donnerruebe/HEC-LadyBug/cad/hec-base/PCB-Outline.dxf

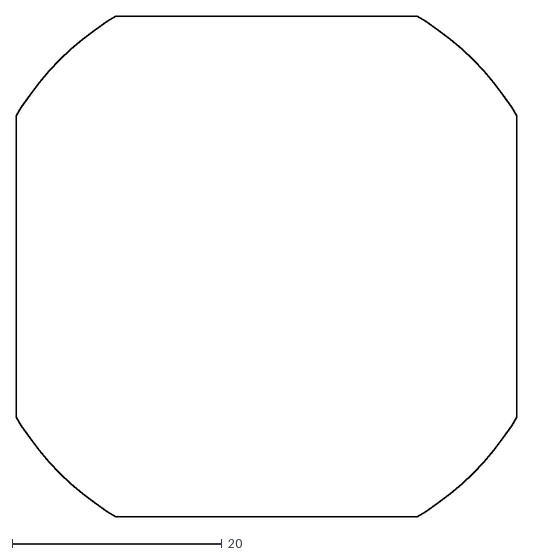
[picture p1: CAD file, 2022-08-14]
cad/hec-base/PCB-Outline.dxf
47.8 x 47.8
