donnerruebe/HEC-LadyBug/SLP/HEC-Base-Board_SCH_color.pdf

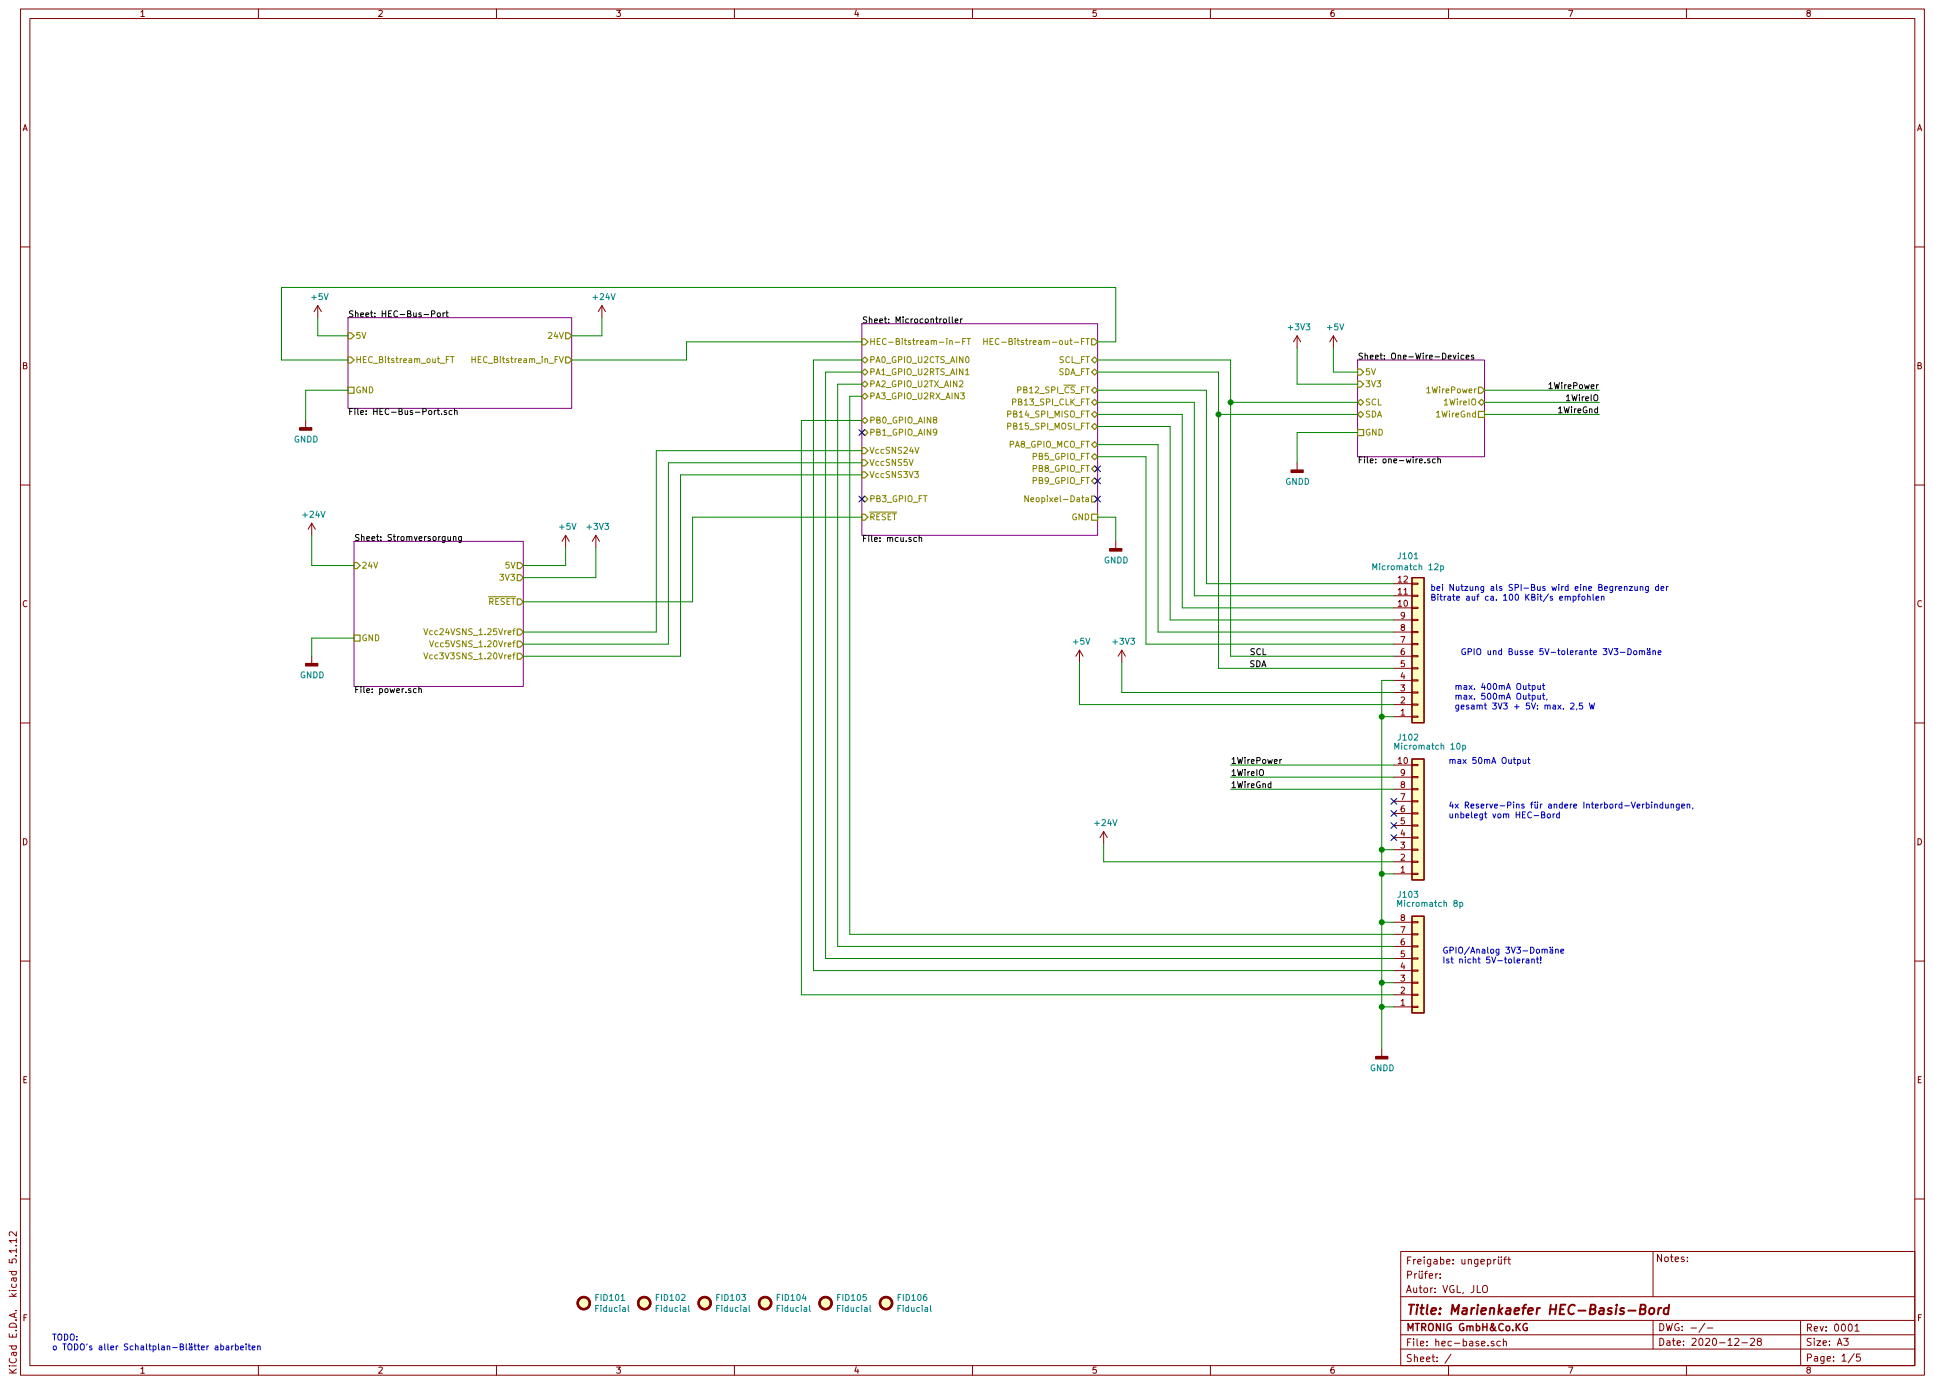
[picture p7: page 1]

Sheet: One-Wire-Devices File: one-wire.sch

GNDD GNDD

11
10

bei Nutzung als SPI-Bus wird eine Begrenzung der
Bitrate auf ca. 100 KBit/s empfohlen

Ist nicht 5V-tolerant! GPIO und Busse 5V-tolerante 3V3-Domäne

4x Reserve-Pins für andere Interbord-Verbindungen,
unbelegt vom HEC-Bord

File: hec-base.sch Sheet: / Autor: VGL, JLO
Title: Marienkaefer HEC-Basis-Bord

TODO: o TODO's aller Schaltplan-Blätter abarbeiten

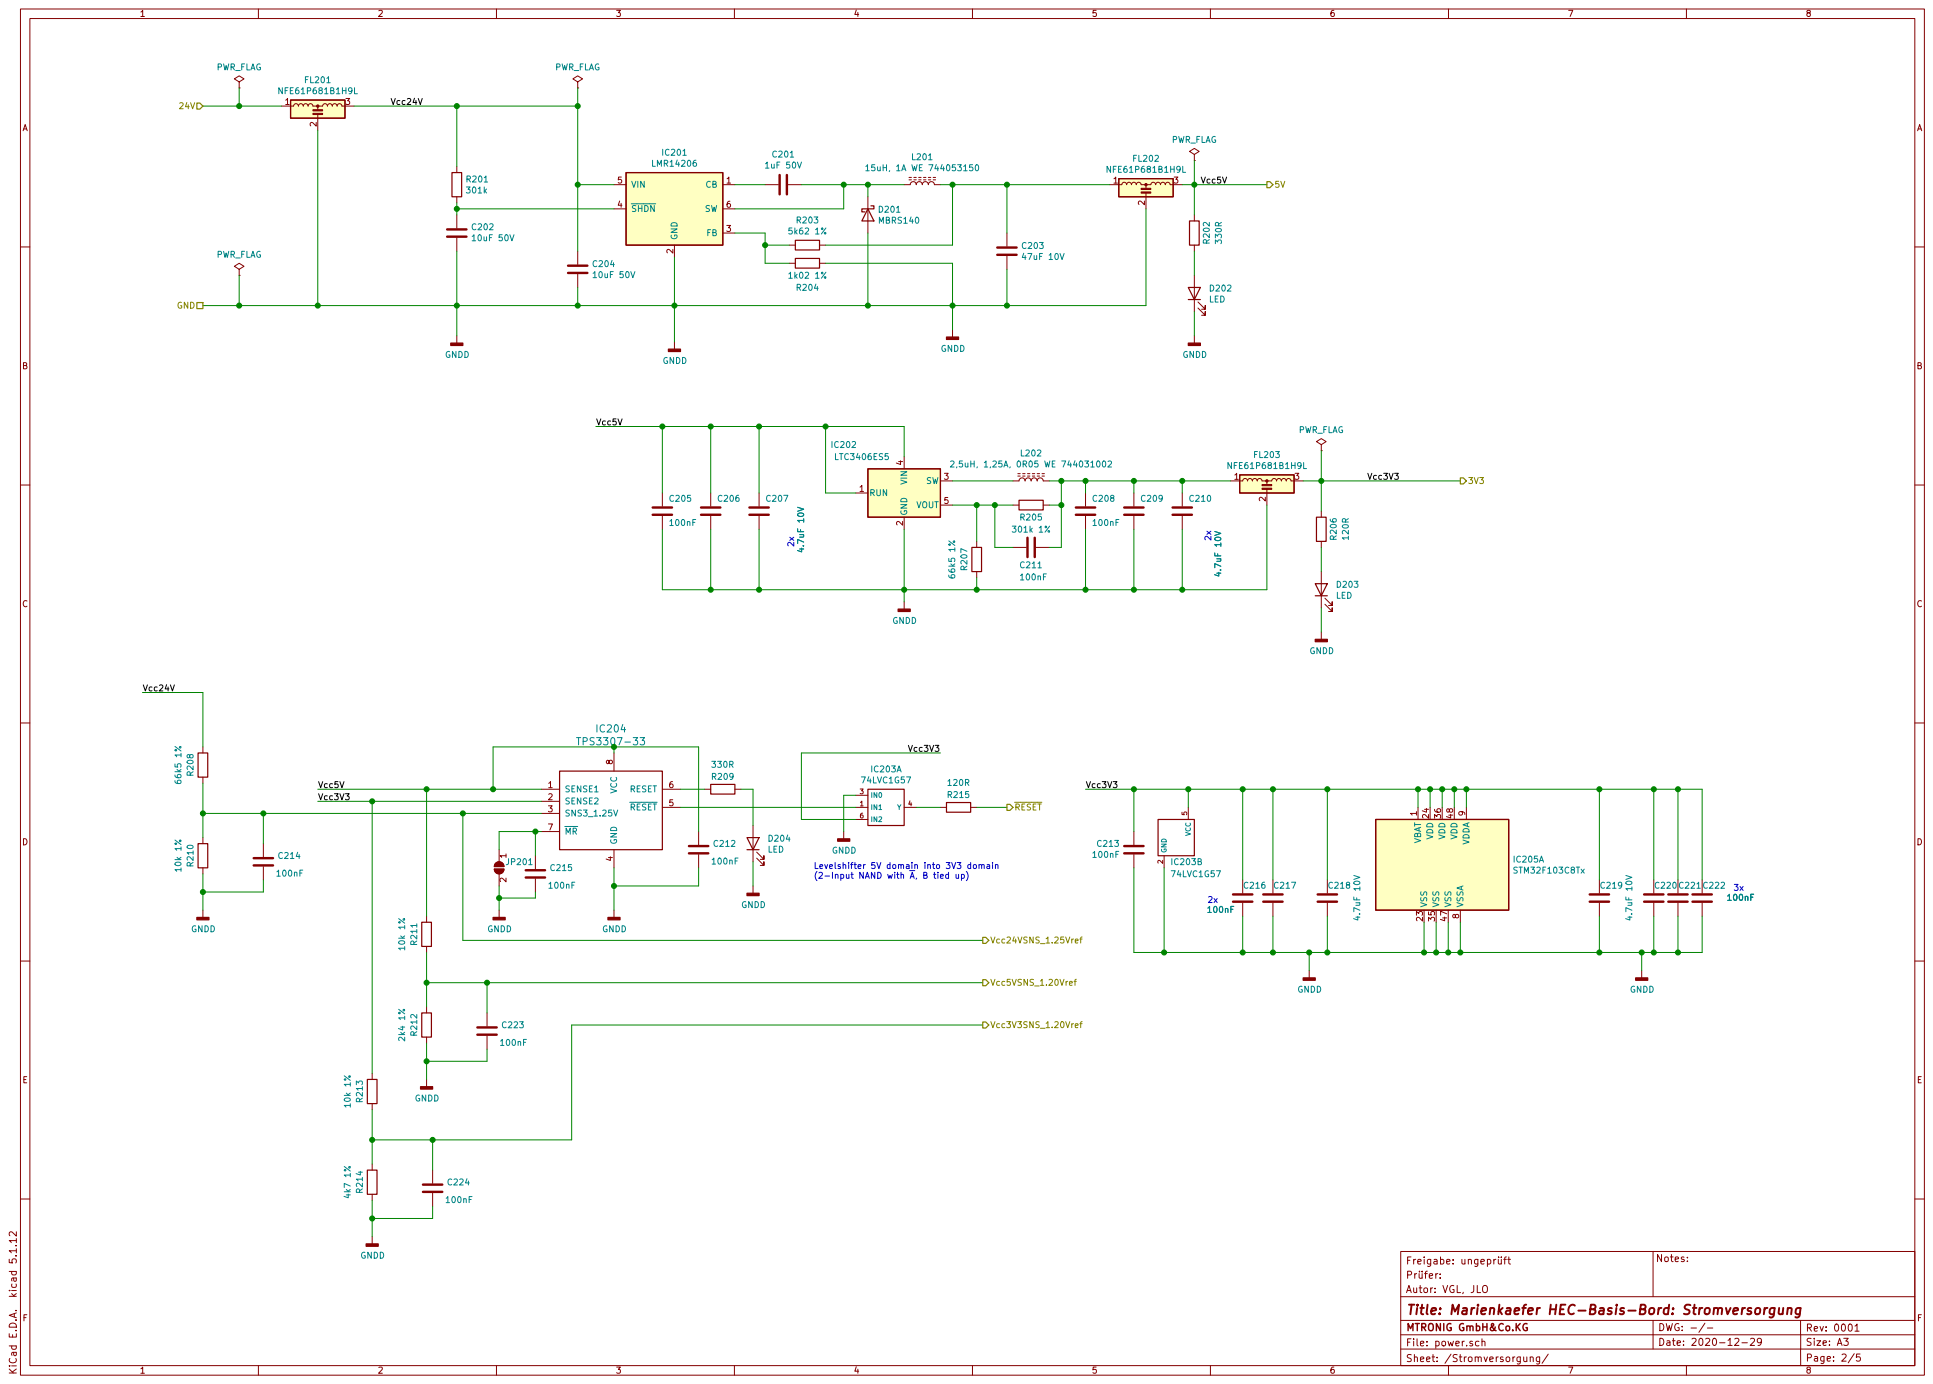
[picture p8: page 2]

2 FB 3 SHDN 4 VIN 5 SW 6

1 VSS 23 VDD 24 VSS 35 VDD 36 VSS 47 VDD 48 VSSA

GNDD
3x Levelshifter 5V domain into 3V3 domain

Autor: VGL, JLO
Title: Marienkaefer HEC-Basis-Bord: Stromversorgung

Rev: 0001 Size: A3 Page: 2/5 | F Date: 2020-12-29

File: power.sch
Sheet: /Stromversorgung/

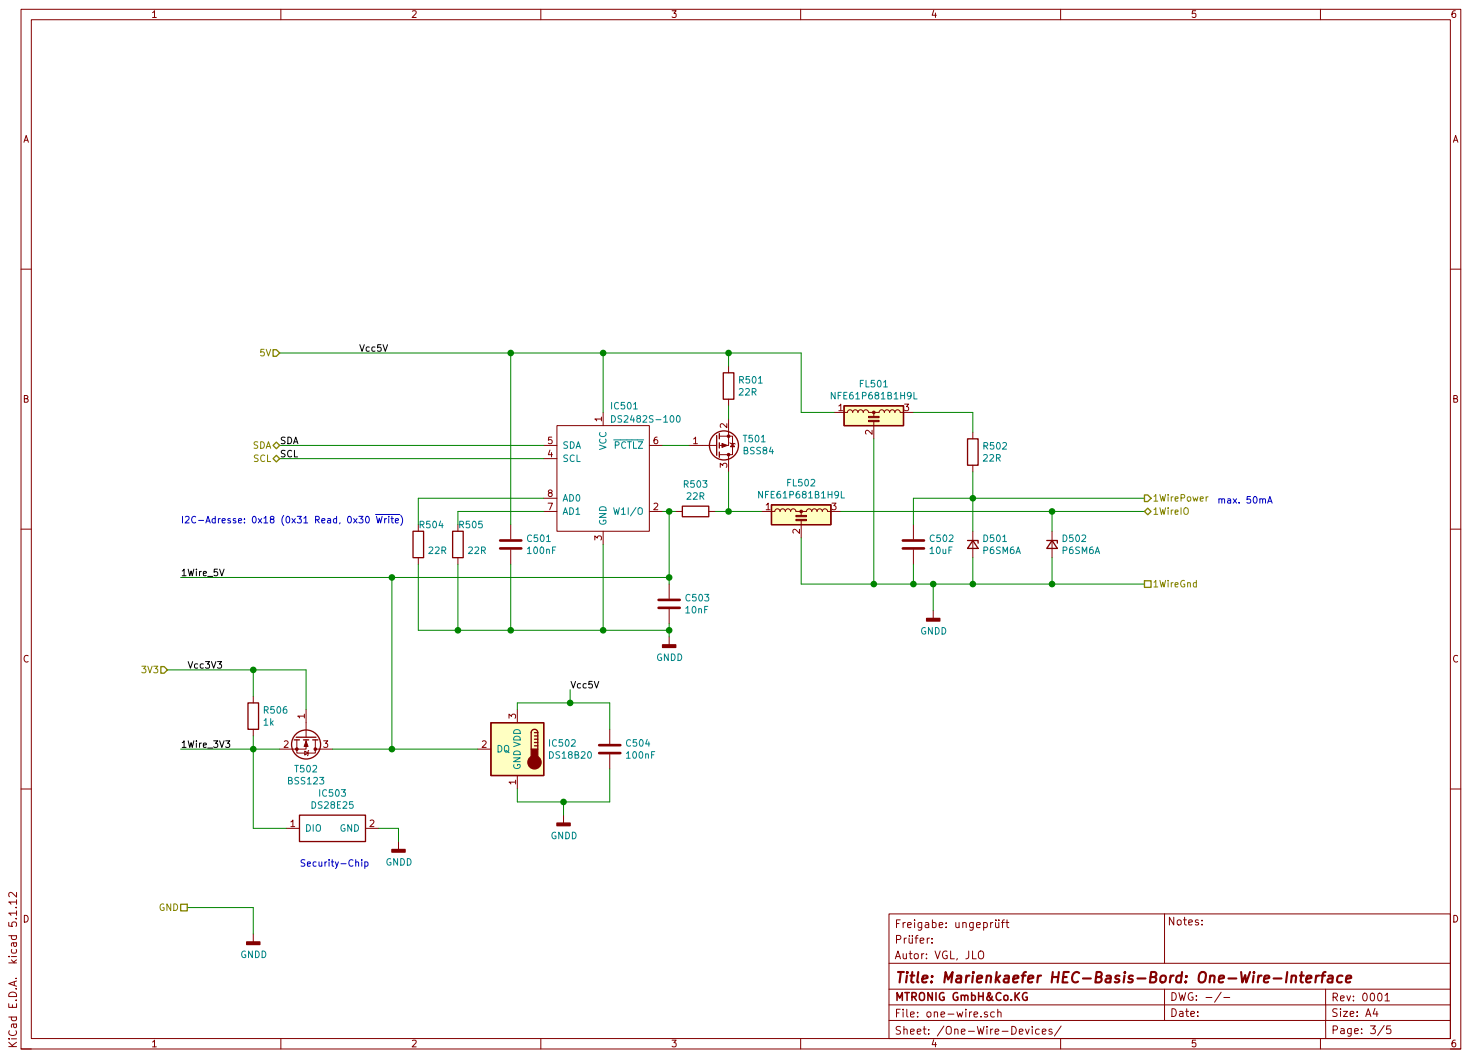
[picture p9: page 3]

File: one-wire.sch Sheet: /One-Wire-Devices/ Autor: VGL, JLO
Title: Marienkaefer HEC-Basis-Bord: One-Wire-Interface

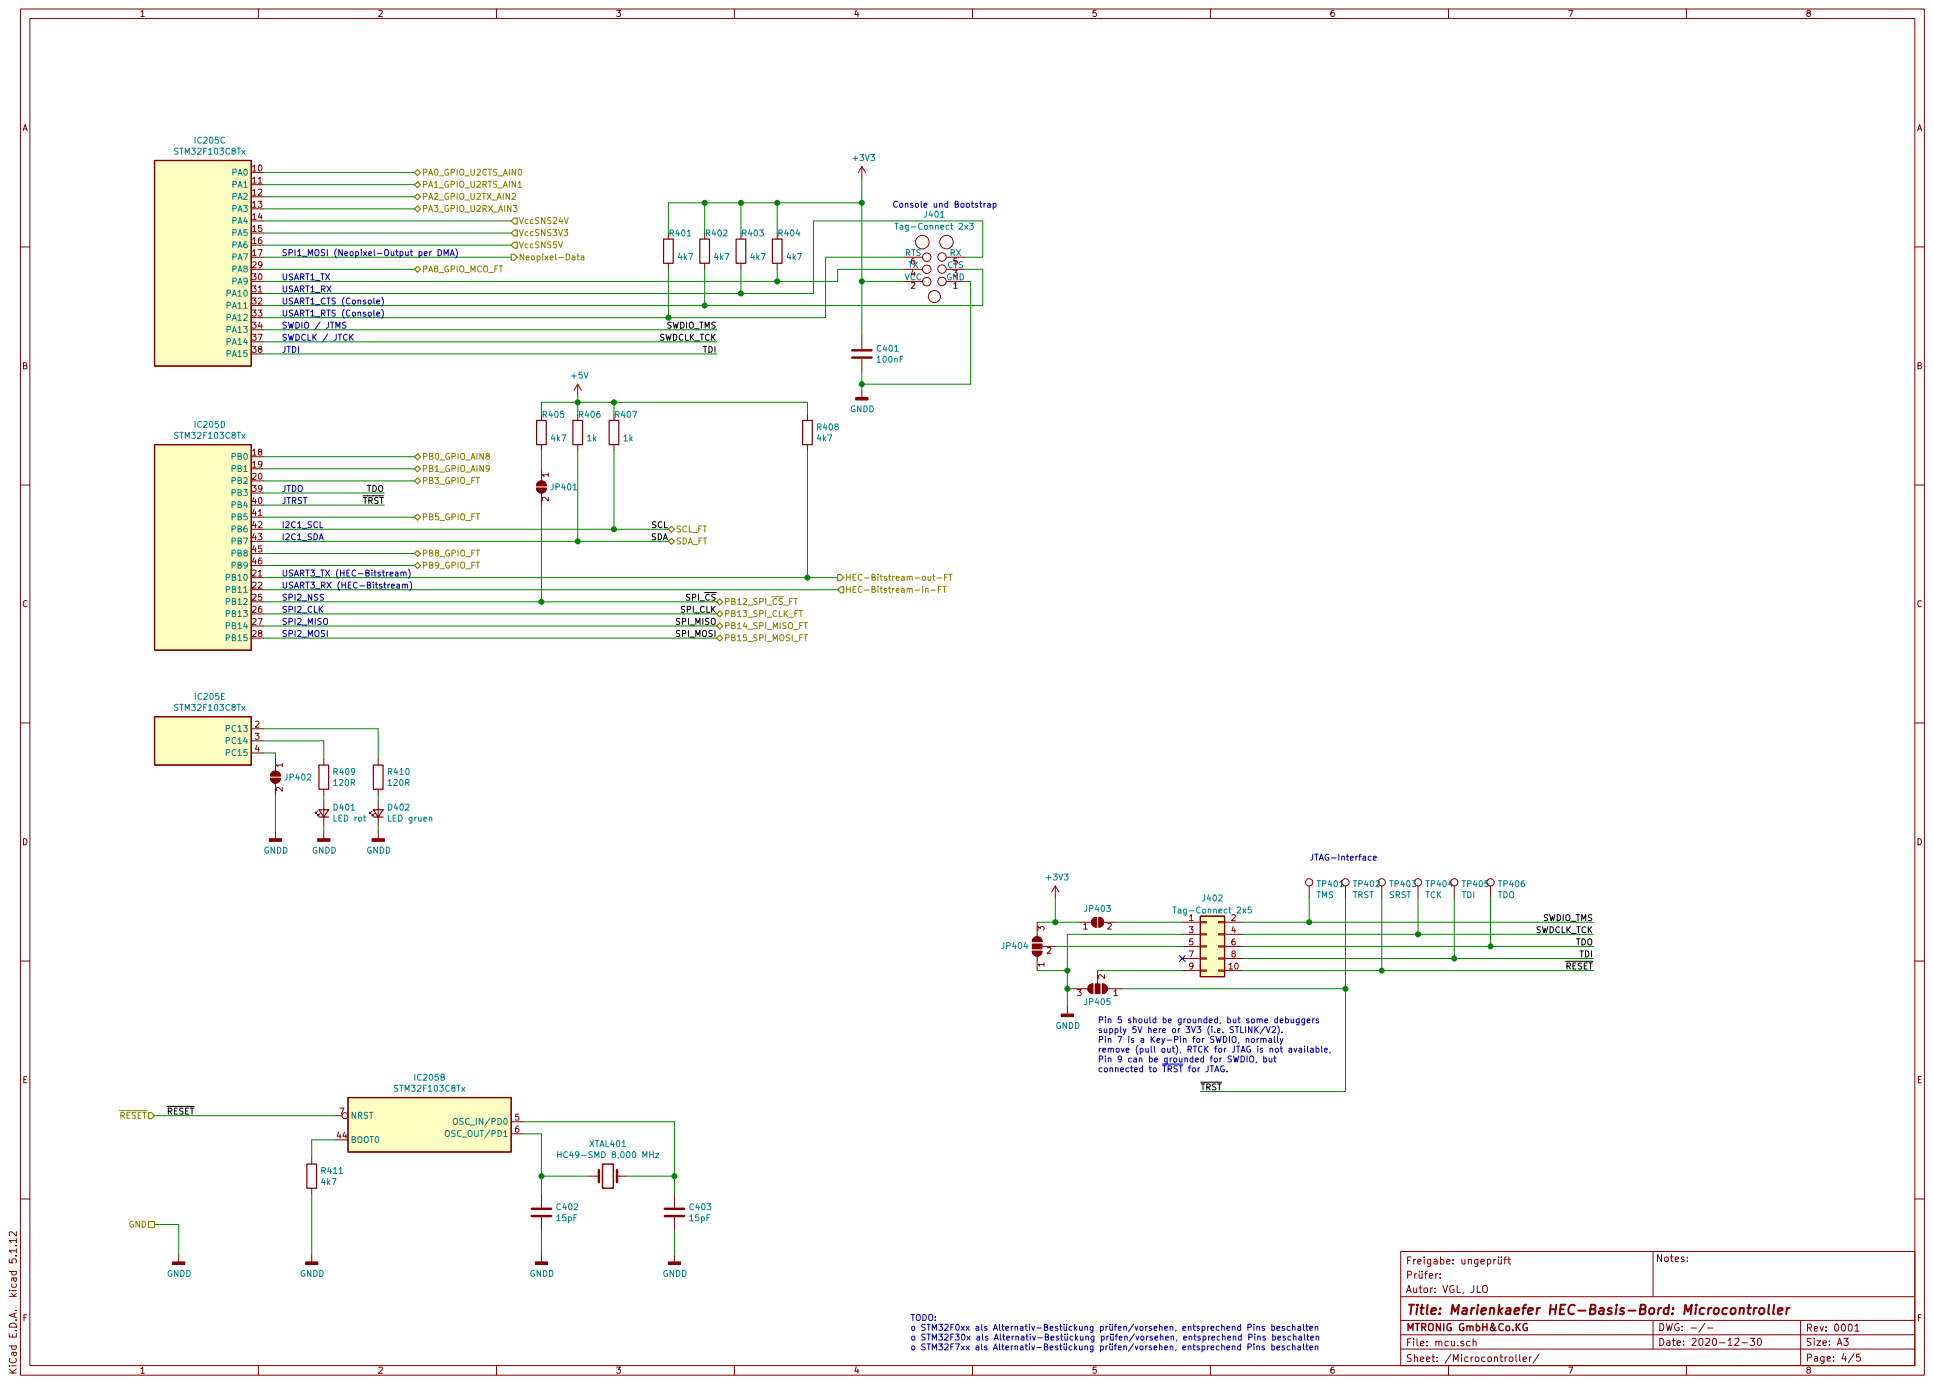
[picture p10: page 4]

SPI1_MOSI (Neopixel-Output per DMA) JTDO
JTRST USART1_TX
USART1_RX USART1_CTS (Console)
JTDI SPI2_NSS

Pin 5 should be grounded, but some debuggers
supply 5V here or 3V3 (i.e. STLINK/V2).
Pin 7 is a Key-Pin for SWDIO, normally
remove (pull out), RTCK for JTAG is not available,
Pin 9 can be grounded for SWDIO, but connected to TRST for JTAG.

Title: Marienkaefer HEC-Basis-Bord: Microcontroller File: mcu.sch Sheet: /Microcontroller/ Autor: VGL, JLO

TODO: o STM32F0xx als Alternativ-Bestückung prüfen/vorsehen, entsprechend Pins beschalten

o STM32F30x als Alternativ-Bestückung prüfen/vorsehen, entsprechend Pins beschalten
o STM32F7xx als Alternativ-Bestückung prüfen/vorsehen, entsprechend Pins beschalten

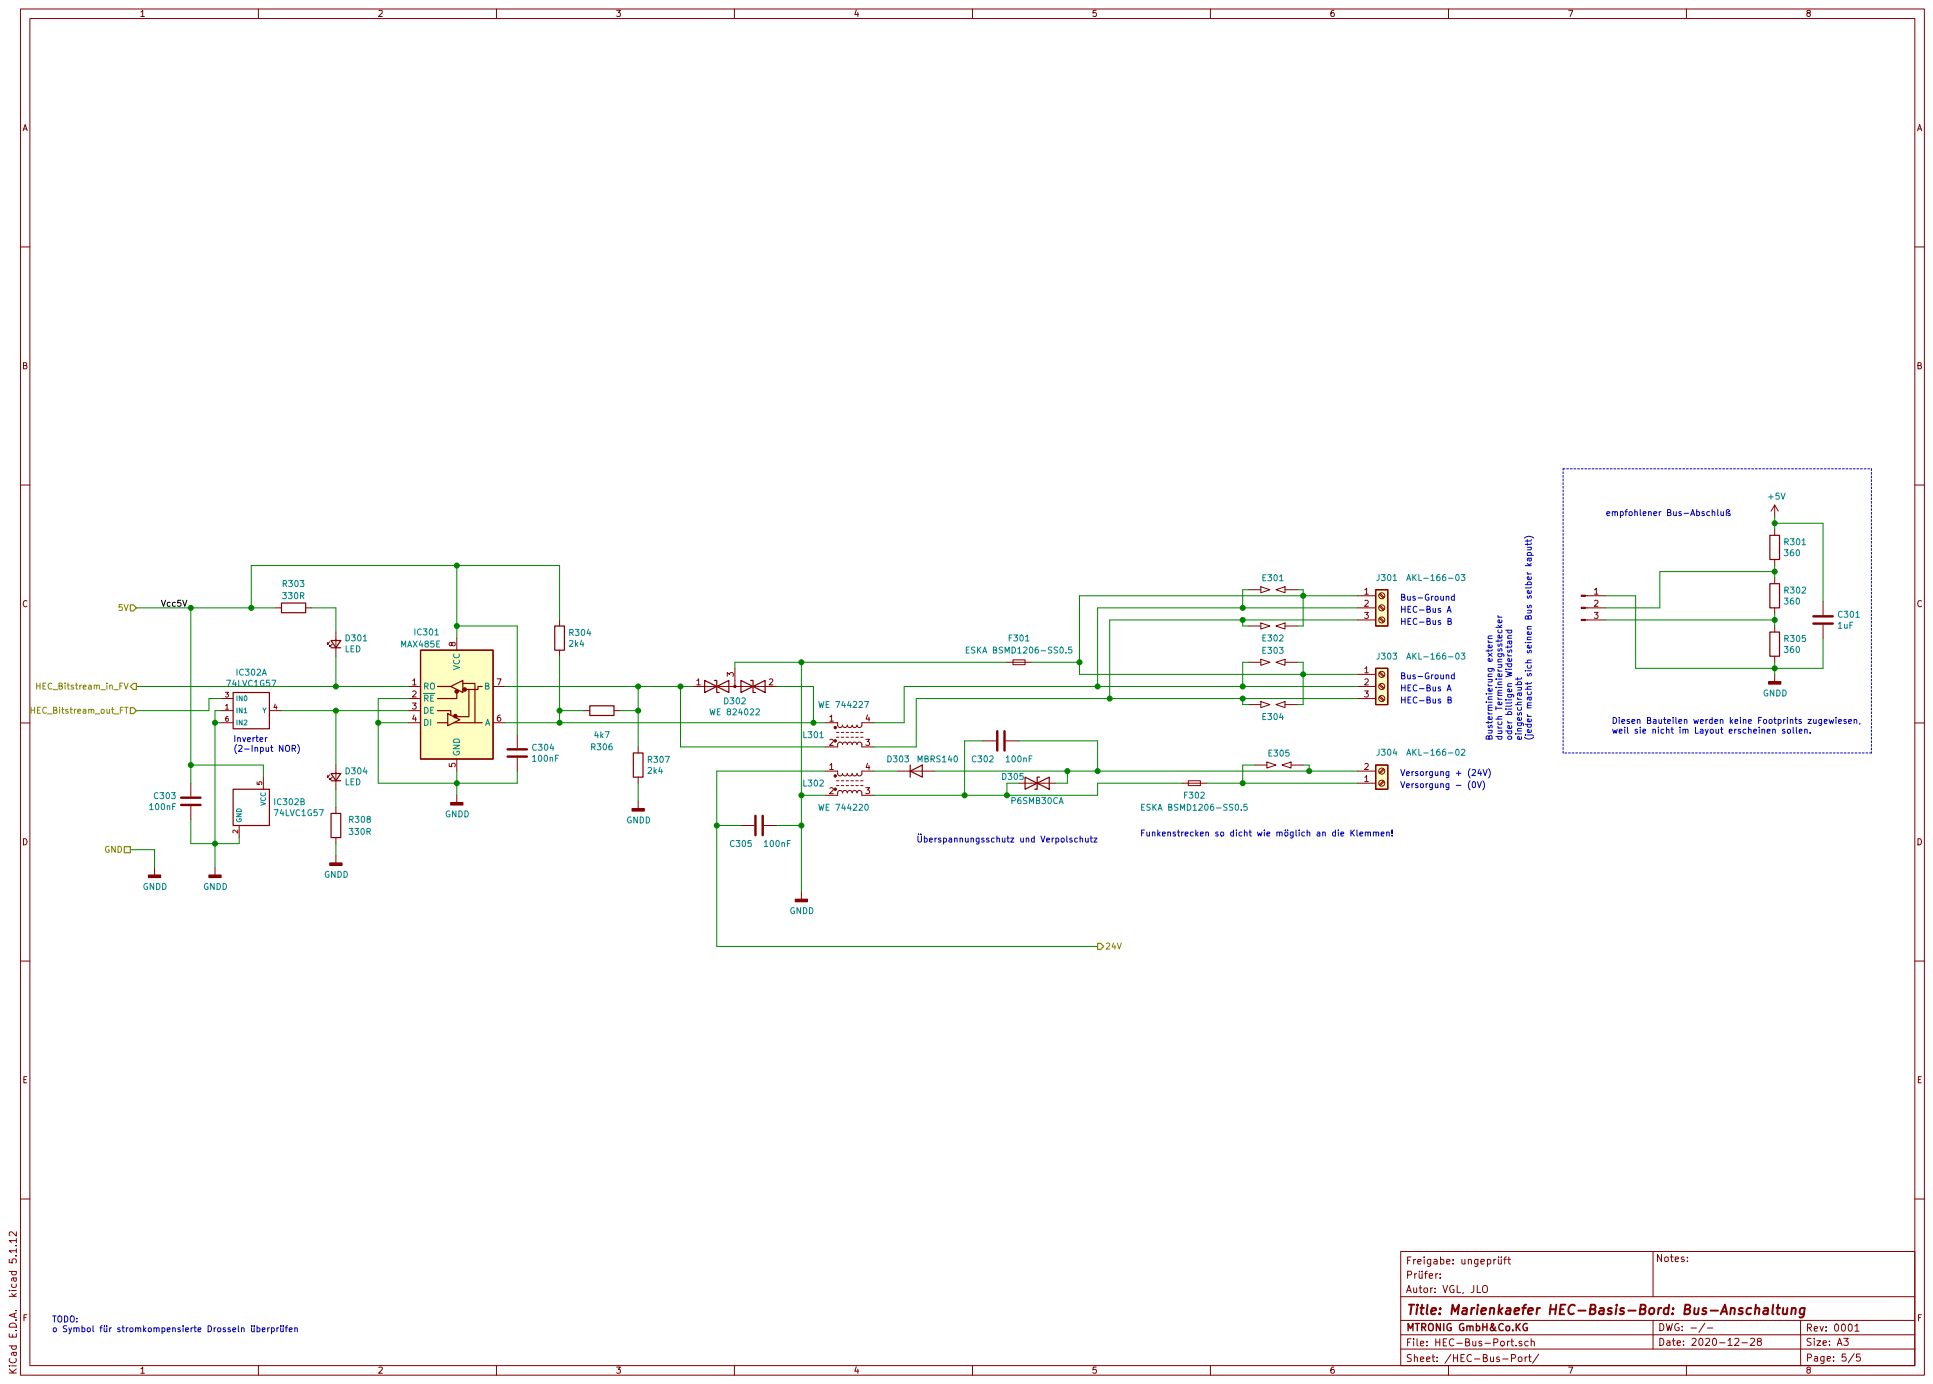
[picture p11: page 5]

Bus-Ground HEC-Bus A
Bus-Ground HEC-Bus A HEC-Bus B

Diesen Bauteilen werden keine Footprints zugewiesen,
weil sie nicht im Layout erscheinen sollen.

File: HEC-Bus-Port.sch Sheet: /HEC-Bus-Port/ Autor: VGL, JLO
Title: Marienkaefer HEC-Basis-Bord: Bus-Anschaltung

TODO: o Symbol für stromkompensierte Drosseln überprüfen
