donnerruebe/HEC-LadyBug/cad/hec-base/hec-base.kicad_pcb

## KiCad design cad/hec-base/hec-base.kicad_pcb (2022-08-14)

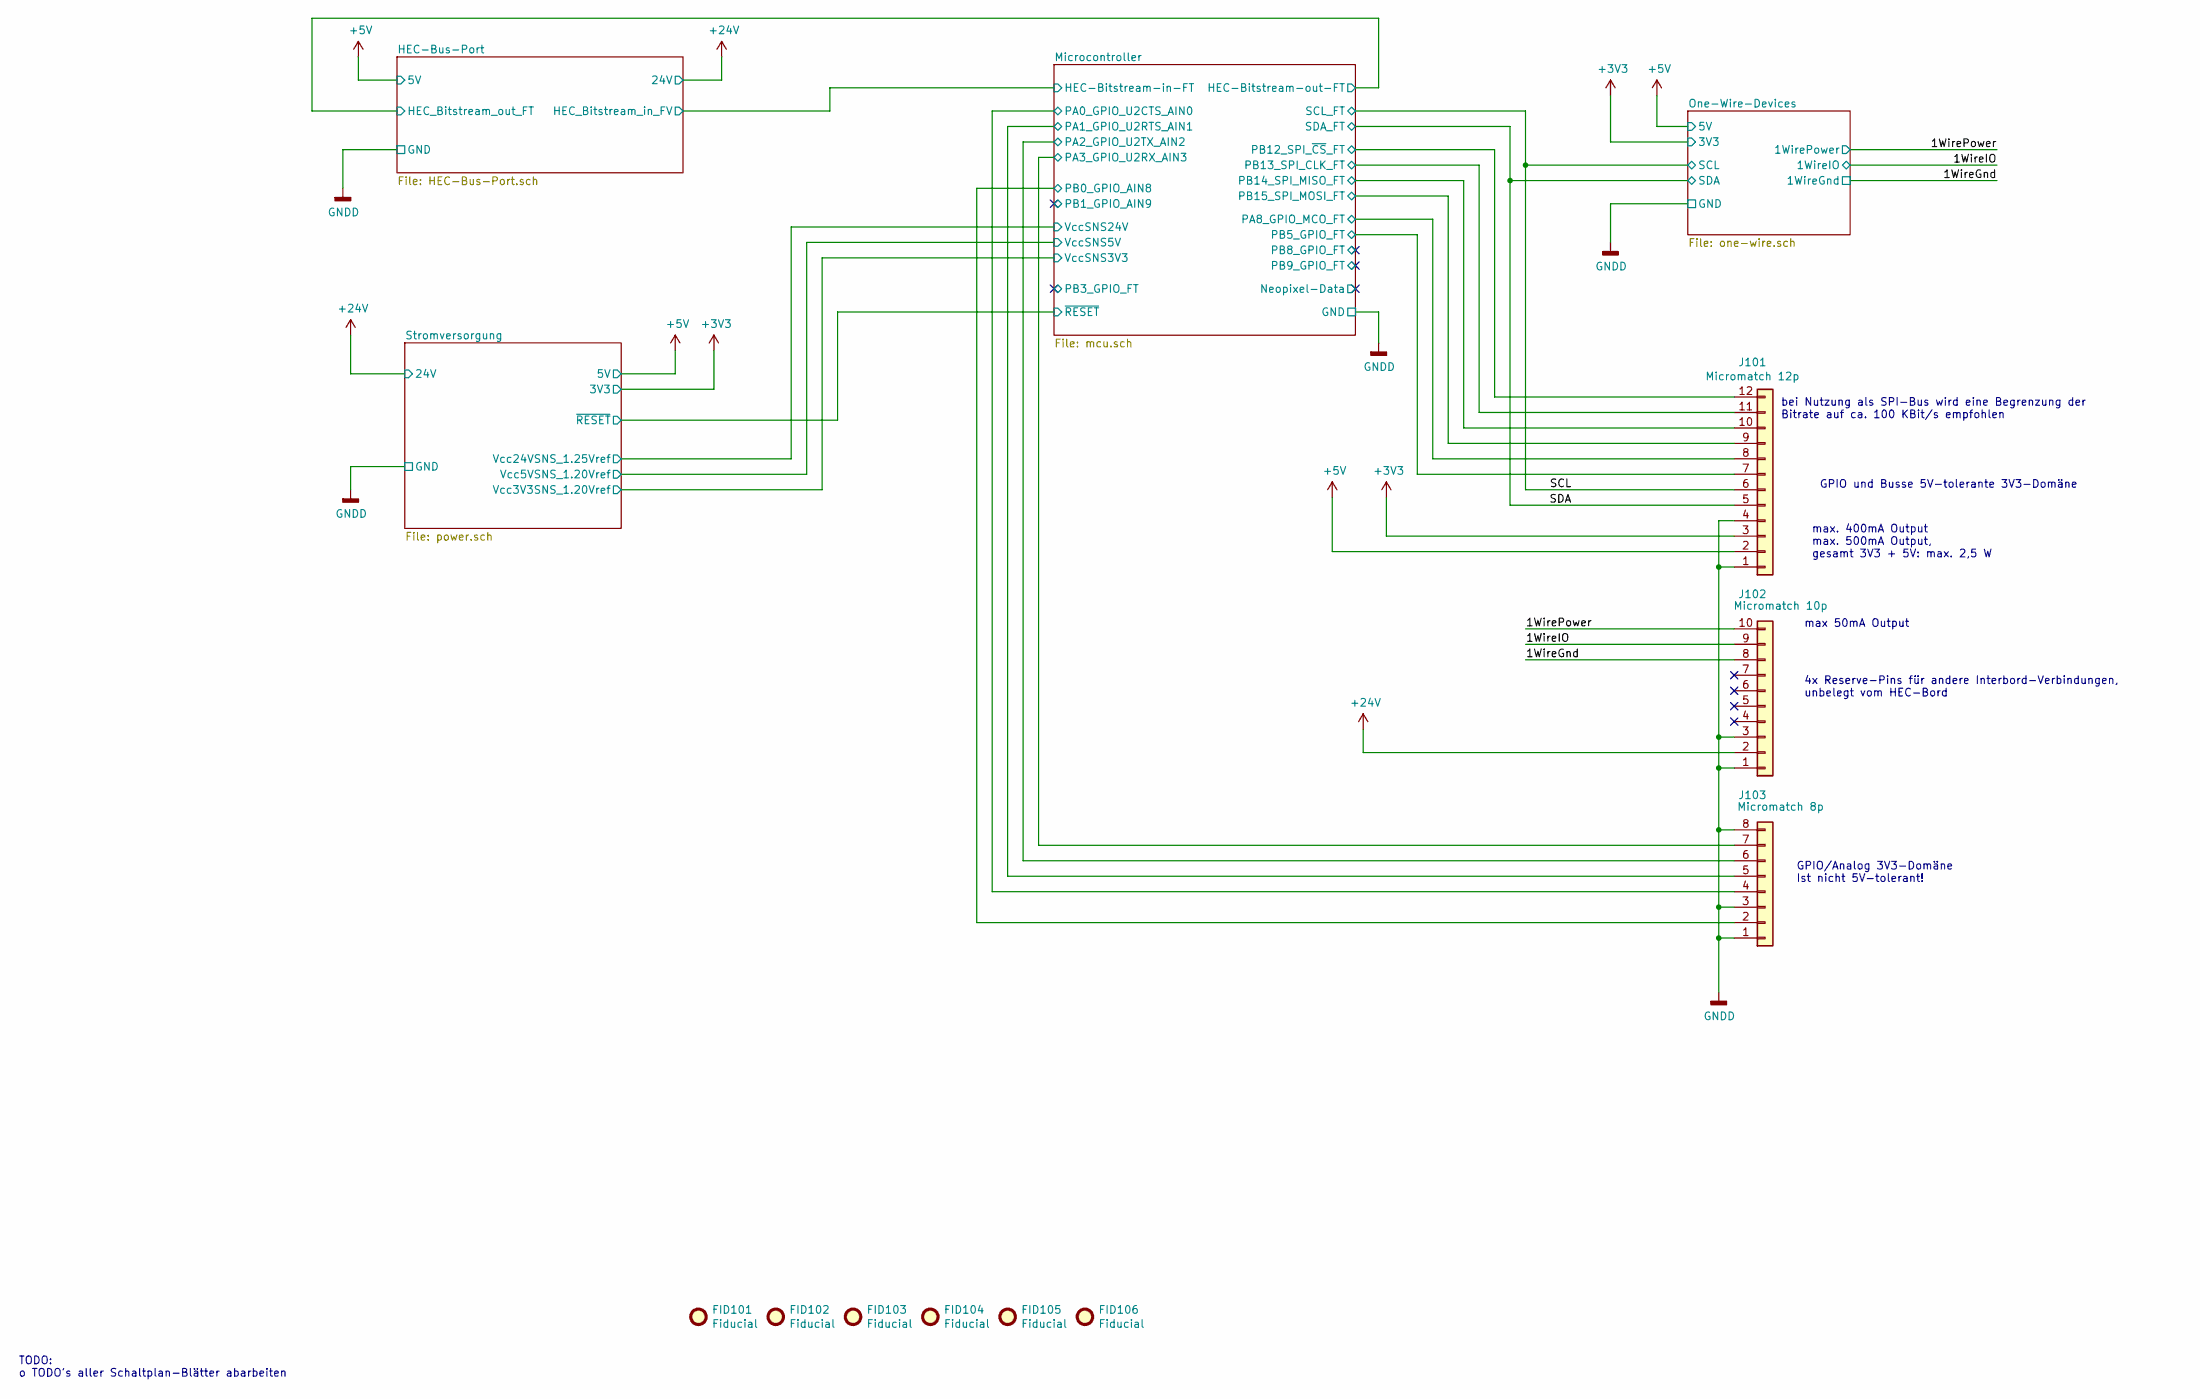
[picture p12: schematic hec-base.sch, Marienkaefer HEC-Basis-Bord]

Parts:
FID101, FID102, FID103, FID104, FID105, FID106: Fiducial; Fiducial_0.5mm_Mask1mm
J101: Micromatch 12p; ConnectorMicromatch-12-horizontal-THT
J102: Micromatch 10p; ConnectorMicromatch-10-horizontal-THT
J103: Micromatch 8p; ConnectorMicromatch-8-SMD-polarized

Connections:
+3V3: J101.3; also elsewhere on the board
+5V: J101.2; also elsewhere on the board
+24V: J102.2; also elsewhere on the board
/1WireIO: J102.9; also elsewhere on the board
/1WirePower: J102.10; also elsewhere on the board
/Microcontroller/PA0_GPIO_U2CTS_AIN0: J103.4; also elsewhere on the board
/Microcontroller/PA1_GPIO_U2RTS_AIN1: J103.5; also elsewhere on the board
/Microcontroller/PA2_GPIO_U2TX_AIN2: J103.6; also elsewhere on the board
/Microcontroller/PA3_GPIO_U2RX_AIN3: J103.7; also elsewhere on the board
/Microcontroller/PA8_GPIO_MCO_FT: J101.8; also elsewhere on the board
/Microcontroller/PB0_GPIO_AIN8: J103.2; also elsewhere on the board
/Microcontroller/PB5_GPIO_FT: J101.7; also elsewhere on the board
/Microcontroller/PB12_SPI_~CS~_FT: J101.12; also elsewhere on the board
/Microcontroller/PB13_SPI_CLK_FT: J101.11; also elsewhere on the board
/Microcontroller/PB14_SPI_MISO_FT: J101.10; also elsewhere on the board
/Microcontroller/PB15_SPI_MOSI_FT: J101.9; also elsewhere on the board
/SCL: J101.6; also elsewhere on the board
/SDA: J101.5; also elsewhere on the board
GNDD: J101.1, J101.4, J102.1, J102.3, J102.8, J103.1, J103.3, J103.8; also elsewhere on the board

Notes on the sheet:
bei Nutzung als SPI-Bus wird eine Begrenzung der Bitrate auf ca. 100 KBit/s empfohlen
GPIO/Analog 3V3-Domäne Ist nicht 5V-tolerant!
GPIO und Busse 5V-tolerante 3V3-Domäne
4x Reserve-Pins für andere Interbord-Verbindungen, unbelegt vom HEC-Bord
max. 400mA Output max. 500mA Output, gesamt 3V3 + 5V: max. 2,5 W
max 50mA Output
TODO: o TODO's aller Schaltplan-Blätter abarbeiten

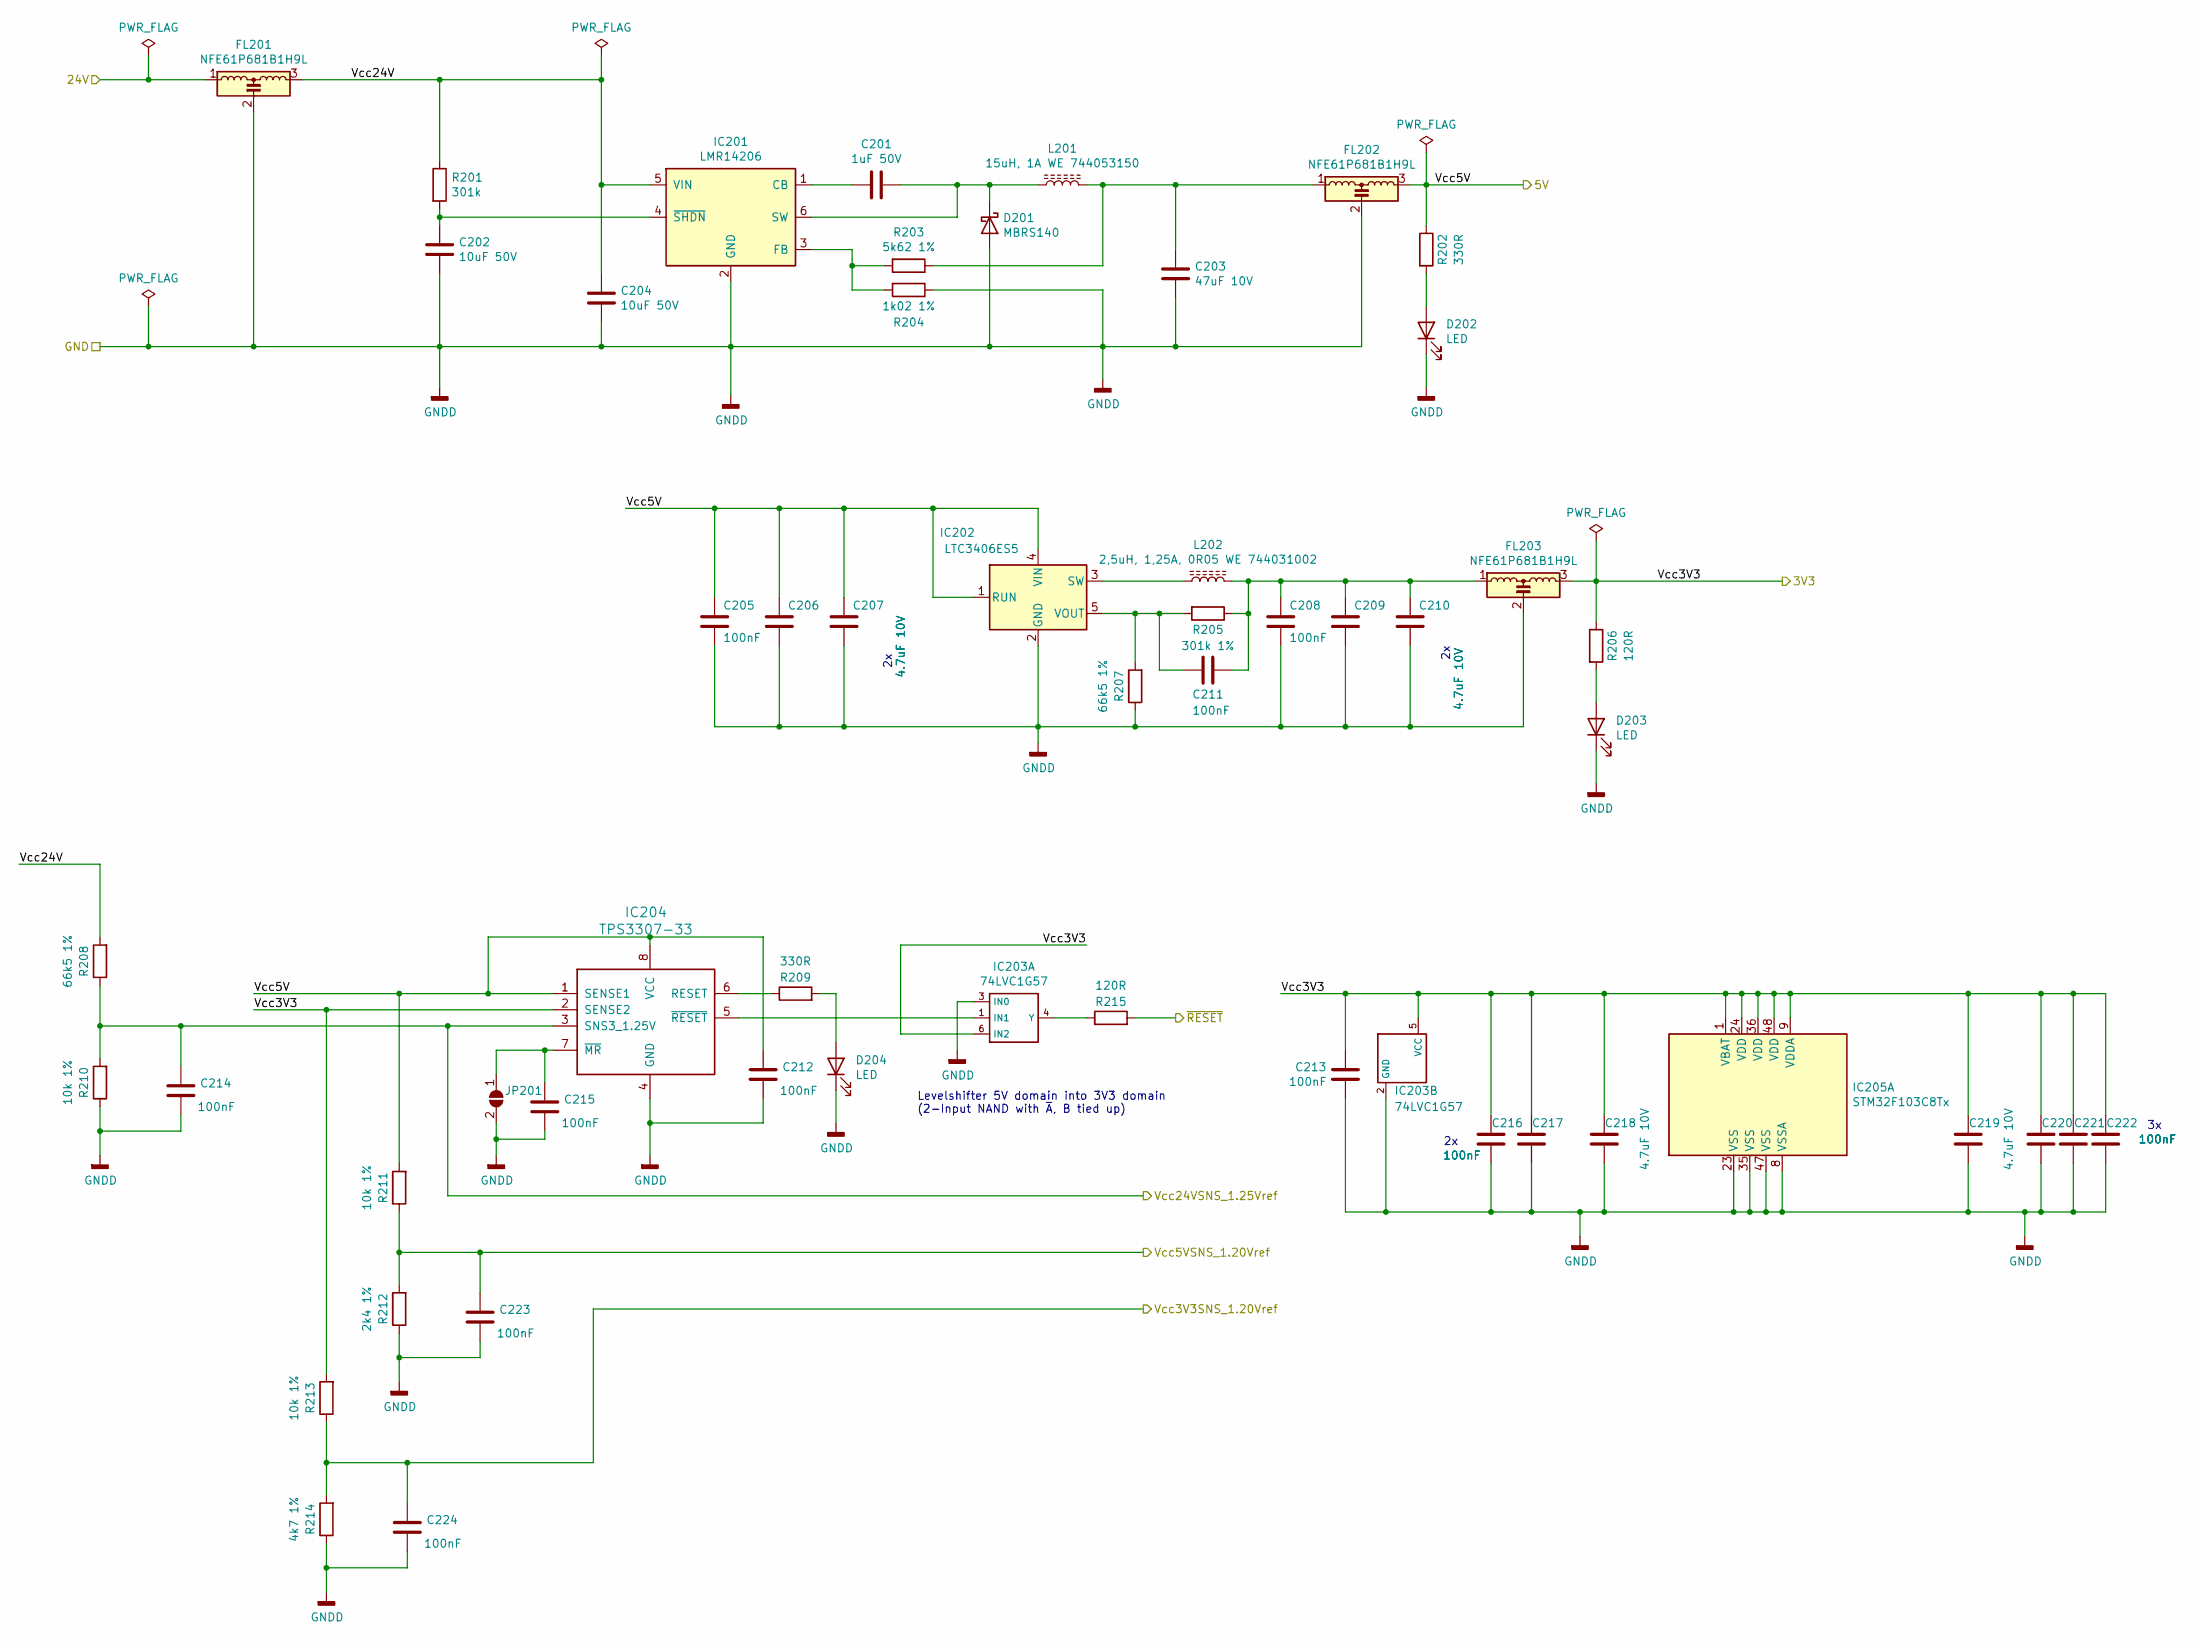
[picture p13: schematic power.sch, Marienkaefer HEC-Basis-Bord: Stromversorgung]

Parts:
C201: 1uF 50V; C_0805_2012Metric
C202, C204: 10uF 50V; C_1206_3216Metric
C203: 47uF 10V; C_1210_3225Metric
C205, C208, C211, C212, C213, C214, C215, C216, C217, C220, C221, C222, C223, C224: 100nF; C_0603_1608Metric
C206, C207, C209, C210, C218, C219: 4.7uF 10V; C_0805_2012Metric
D201: MBRS140; D_SMB
D202, D203, D204: LED; LED_0603_1608Metric
FL201, FL202, FL203: NFE61P681B1H9L; Murata_NFE61P
IC201: LMR14206; SOT-23-6
IC202: LTC3406ES5; TSOT-23-5
IC203: 74LVC1G57; SOT-363_SC-70-6
IC204: TPS3307-33; SO-8_3.9x4.9mm_P1.27mm
IC205: STM32F103C8Tx; LQFP-48_7x7mm_P0.5mm
JP201: SolderJumper_2_Open; SolderJumper-2_P1.3mm_Open_RoundedPad1.0x1.5mm
L201: 15uH, 1A WE 744053150; L_Wuerth_WE-TPC-3816
L202: 2,5uH, 1,25A, 0R05 WE 744031002; L_Wuerth_WE-TPC-3816
R201: 301k; R_0603_1608Metric
R202, R209: 330R; R_0603_1608Metric
R203: 5k62 1%; R_0603_1608Metric
R204: 1k02 1%; R_0603_1608Metric
R205: 301k 1%; R_0603_1608Metric
R206, R215: 120R; R_0603_1608Metric
R207, R208: 66k5 1%; R_0603_1608Metric
R210, R211, R213: 10k 1%; R_0603_1608Metric
R212: 2k4 1%; R_0603_1608Metric
R214: 4k7 1%; R_0603_1608Metric

Connections:
+3V3: C213.2, C216.2, C217.2, C218.2, C219.2, C220.2, C221.2, C222.2, FL203.3, IC203.5 (VCC), IC203.6 (IN2), IC204.2 (SENSE2), IC205.1 (VBAT), IC205.9 (VDDA), IC205.24 (VDD), IC205.36 (VDD), IC205.48 (VDD), R206.1, R213.2; also elsewhere on the board
+5V: C205.2, C206.2, C207.2, C212.2, FL202.3, IC202.1 (RUN), IC202.4 (VIN), IC204.1 (SENSE1), IC204.8 (VCC), R202.1, R211.2; also elsewhere on the board
+24V: FL201.1; also elsewhere on the board
/Microcontroller/~RESET~: R215.2; also elsewhere on the board
/Stromversorgung/Vcc3V3SNS_1.20Vref: C224.2, R213.1, R214.2; also elsewhere on the board
/Stromversorgung/Vcc5VSNS_1.20Vref: C223.2, R211.1, R212.2; also elsewhere on the board
/Stromversorgung/Vcc24V: C204.1, FL201.3, IC201.5 (VIN), R201.1, R208.2
/Stromversorgung/Vcc24VSNS_1.25Vref: C214.2, IC204.3 (SNS3_1.25V), R208.1, R210.2; also elsewhere on the board
GNDD: C202.1, C203.2, C204.2, C205.1, C206.1, C207.1, C208.1, C209.1, C210.1, C212.1, C213.1, C214.1, C215.1, C216.1, C217.1, C218.1, C219.1, C220.1, C221.1, C222.1, C223.1, C224.1, D201.2 (A), D202.1 (K), D203.1 (K), D204.1 (K), FL201.2, FL202.2, FL203.2, IC201.2 (GND), IC202.2 (GND), IC203.2 (GND), IC203.3 (IN0), IC204.4 (GND), IC205.8 (VSSA), IC205.23 (VSS), IC205.35 (VSS), IC205.47 (VSS), JP201.2 (B), R204.1, R207.1, R210.1, R212.1, R214.1; also elsewhere on the board
unnamed: C201.1, D201.1 (K), IC201.6 (SW), L201.1
unnamed: C201.2, IC201.1 (CB)
unnamed: C202.2, IC201.4 (~SHDN), R201.2
unnamed: C203.1, FL202.1, L201.2, R203.1
unnamed: C208.2, C209.2, C210.2, C211.2, FL203.1, L202.2, R205.1
unnamed: C211.1, IC202.5 (VOUT), R205.2, R207.2
unnamed: C215.2, IC204.7 (~MR), JP201.1 (A)
unnamed: D202.2 (A), R202.2
unnamed: D203.2 (A), R206.2
unnamed: D204.2 (A), R209.2
unnamed: IC201.3 (FB), R203.2, R204.2
unnamed: IC202.3 (SW), L202.1
unnamed: IC203.1 (IN1), IC204.5 (~RESET)
unnamed: IC203.4 (Y), R215.1
unnamed: IC204.6 (RESET), R209.1

Notes on the sheet:
Levelshifter 5V domain into 3V3 domain (2-Input NAND with ~A~, B tied up)

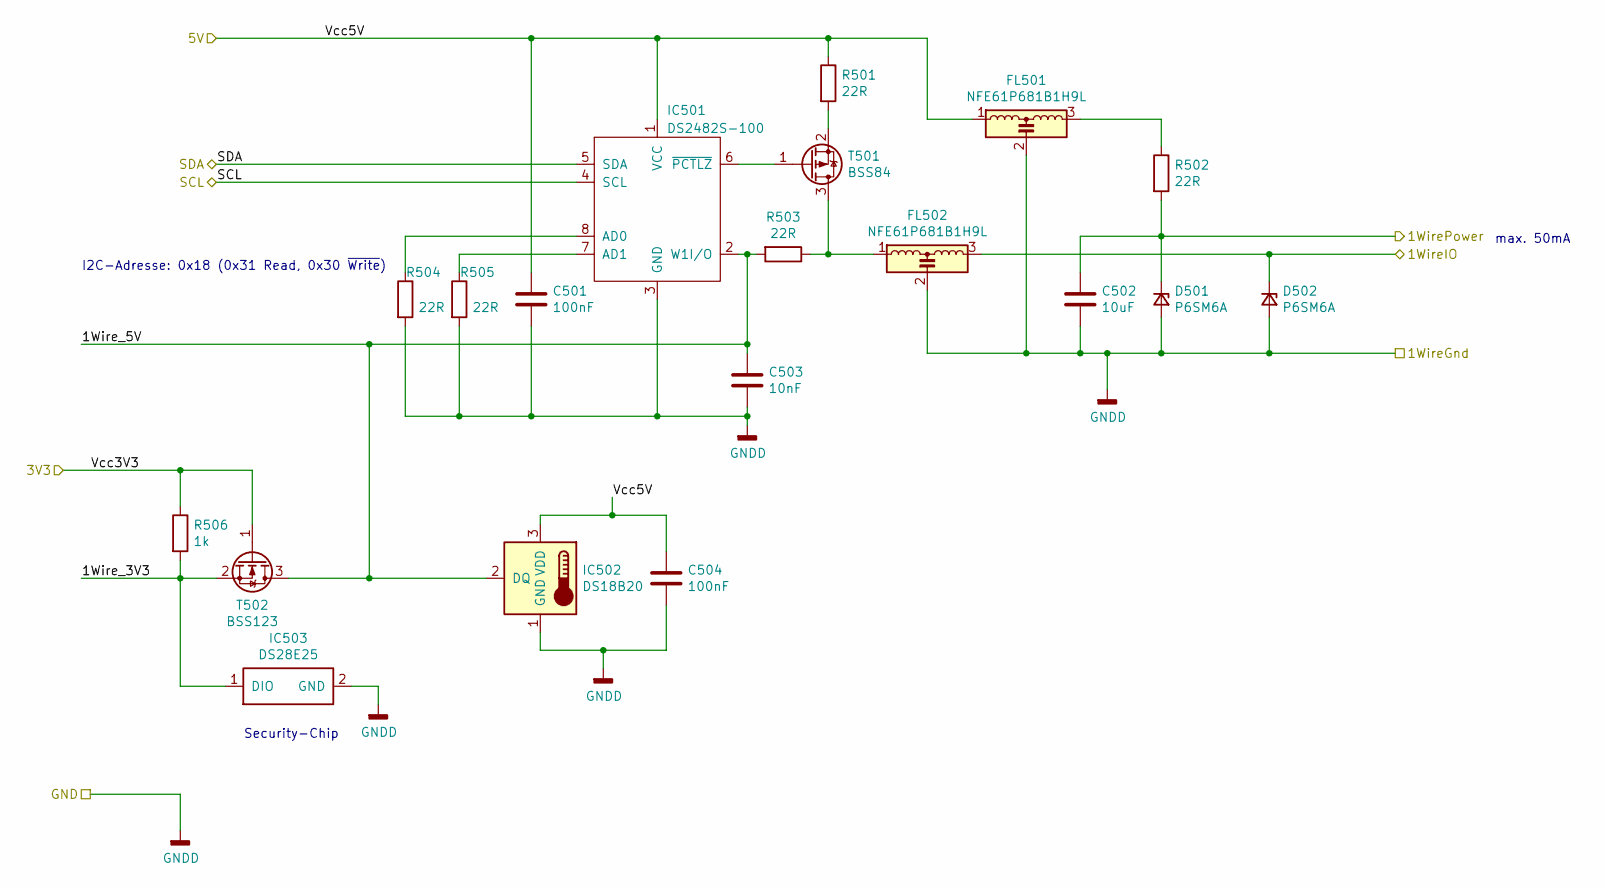
[picture p14: schematic one-wire.sch, Marienkaefer HEC-Basis-Bord: One-Wire-Interface]

Parts:
C501, C504: 100nF; C_0603_1608Metric
C502: 10uF; C_0805_2012Metric
C503: 10nF; C_0603_1608Metric
D501, D502: P6SM6A; D_SMB
FL501, FL502: NFE61P681B1H9L; Murata_NFE61P
IC501: DS2482S-100; SO-8_3.9x4.9mm_P1.27mm
IC502: DS18B20; TO-92_Inline
IC503: DS28E25; TO-92-2
R501, R502, R503, R504, R505: 22R; R_0603_1608Metric
R506: 1k; R_0603_1608Metric
T501: BSS84; SOT-23
T502: BSS123; SOT-23

Connections:
+3V3: R506.1, T502.1 (G); also elsewhere on the board
+5V: C501.1, C504.1, FL501.1, IC501.1 (VCC), IC502.3 (VDD), R501.1; also elsewhere on the board
/1WireIO: D502.1 (K), FL502.3; also elsewhere on the board
/1WirePower: C502.1, D501.1 (K), R502.2; also elsewhere on the board
/One-Wire-Devices/1Wire_3V3: IC503.1 (DIO), R506.2, T502.2 (S)
/One-Wire-Devices/1Wire_5V: C503.1, IC501.2 (W1I/O), IC502.2 (DQ), R503.2, T502.3 (D)
/SCL: IC501.4 (SCL); also elsewhere on the board
/SDA: IC501.5 (SDA); also elsewhere on the board
GNDD: C501.2, C502.2, C503.2, C504.2, D501.2 (A), D502.2 (A), FL501.2, FL502.2, IC501.3 (GND), IC502.1 (GND), IC503.2 (GND), R504.2, R505.2; also elsewhere on the board
unnamed: FL501.3, R502.1
unnamed: FL502.1, R503.1, T501.3 (D)
unnamed: IC501.6 (~PCTLZ~), T501.1 (G)
unnamed: IC501.7 (AD1), R505.1
unnamed: IC501.8 (AD0), R504.1
unnamed: R501.2, T501.2 (S)

Notes on the sheet:
max. 50mA
I2C-Adresse: 0x18 (0x31 Read, 0x30 ~Write~)
Security-Chip

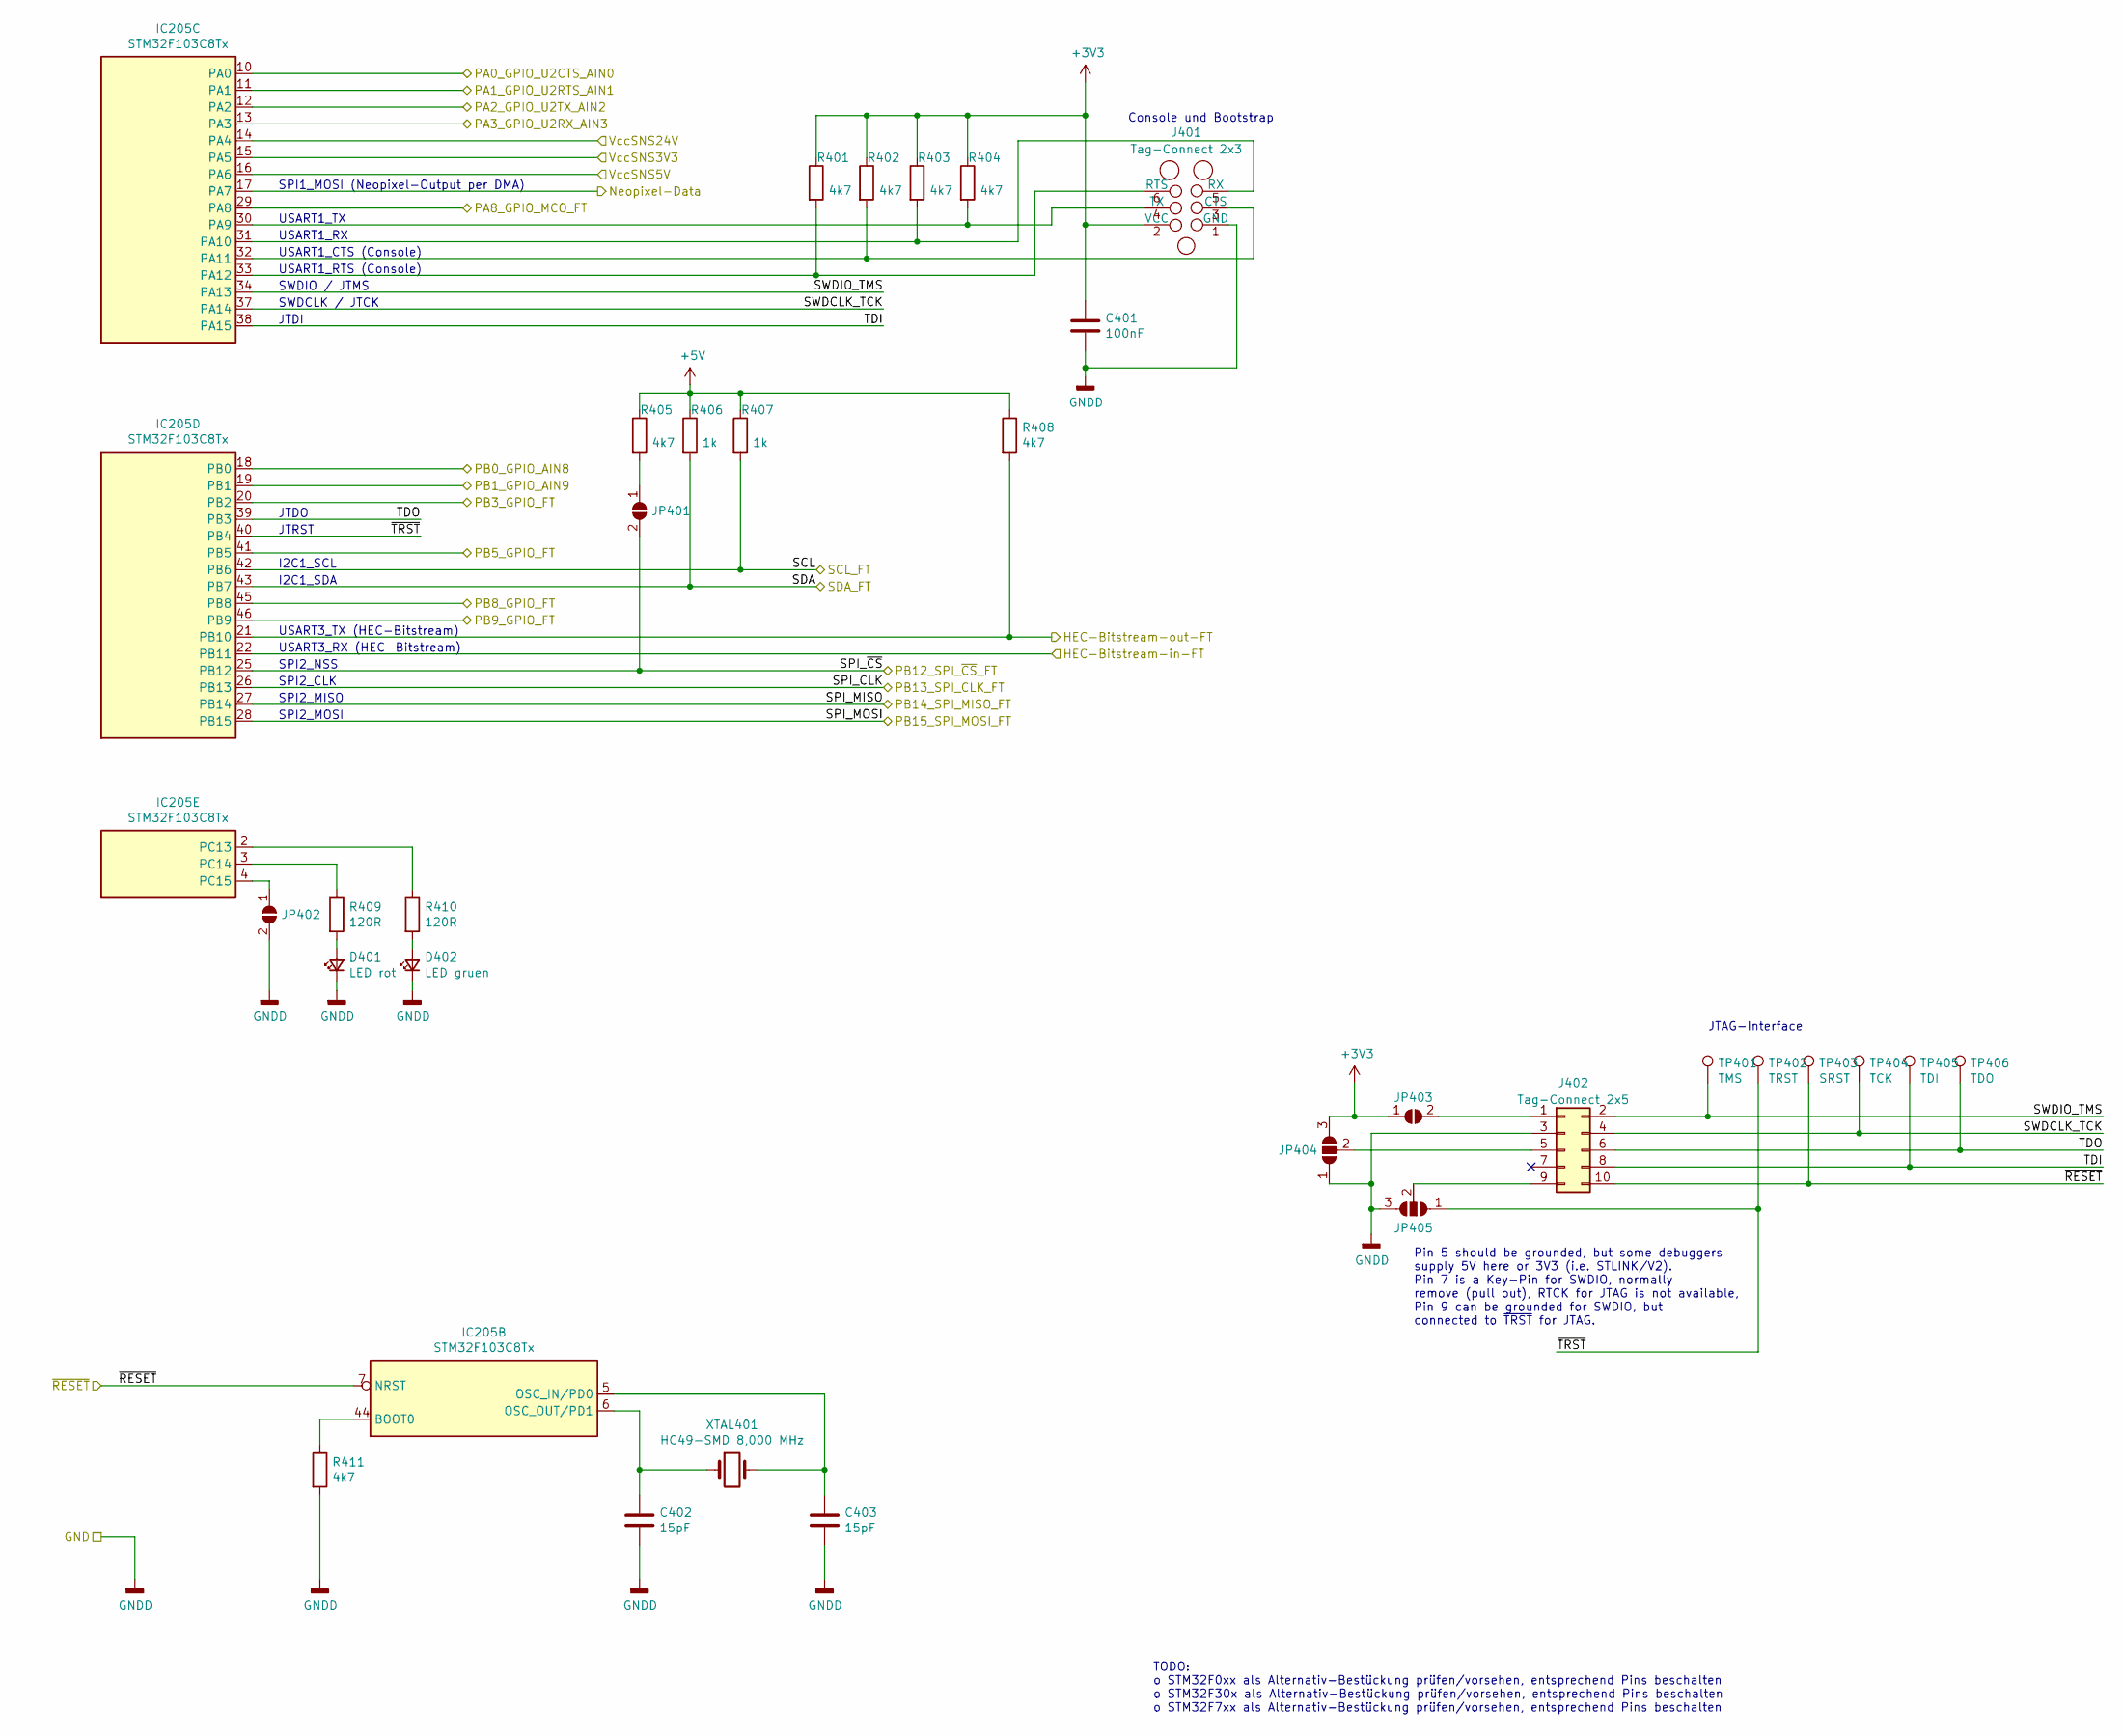
[picture p15: schematic mcu.sch, Marienkaefer HEC-Basis-Bord: Microcontroller]

Parts:
C401: 100nF; C_0603_1608Metric
C402, C403: 15pF; C_0603_1608Metric
D401: LED rot; LED_0603_1608Metric
D402: LED gruen; LED_0603_1608Metric
IC205: STM32F103C8Tx; LQFP-48_7x7mm_P0.5mm
J401: Tag-Connect 2x3; Tag-Connect_TC2030-IDC-NL_2x03_P1.27mm_Vertical
J402: Tag-Connect 2x5; Tag-Connect_TC2050-IDC-NL_2x05_P1.27mm_Vertical
JP401, JP403: SolderJumper_2_Open; SolderJumper-2_P1.3mm_Open_TrianglePad1.0x1.5mm
JP402: SolderJumper_2_Open; SolderJumper-2_P1.3mm_Open_RoundedPad1.0x1.5mm
JP404, JP405: SolderJumper_3_Open; SolderJumper-3_P1.3mm_Open_RoundedPad1.0x1.5mm_NumberLabels
R401, R402, R403, R404, R405, R408, R411: 4k7; R_0603_1608Metric
R406, R407: 1k; R_0603_1608Metric
R409, R410: 120R; R_0603_1608Metric
TP401: TMS; TestPoint_Pad_D1.0mm
TP402: TRST; TestPoint_Pad_D1.0mm
TP403: SRST; TestPoint_Pad_D1.0mm
TP404: TCK; TestPoint_Pad_D1.0mm
TP405: TDI; TestPoint_Pad_D1.0mm
TP406: TDO; TestPoint_Pad_D1.0mm
XTAL401: HC49-SMD 8,000 MHz; Crystal_SMD_HC49-SD

Connections:
+3V3: C401.1, J401.2 (VCC), JP403.1 (A), JP404.3 (B), R401.1, R402.1, R403.1, R404.1; also elsewhere on the board
+5V: R405.1, R406.1, R407.1, R408.1; also elsewhere on the board
/Microcontroller/HEC-Bitstream-in-FT: IC205.22 (PB11); also elsewhere on the board
/Microcontroller/HEC-Bitstream-out-FT: IC205.21 (PB10), R408.2; also elsewhere on the board
/Microcontroller/PA0_GPIO_U2CTS_AIN0: IC205.10 (PA0); also elsewhere on the board
/Microcontroller/PA1_GPIO_U2RTS_AIN1: IC205.11 (PA1); also elsewhere on the board
/Microcontroller/PA2_GPIO_U2TX_AIN2: IC205.12 (PA2); also elsewhere on the board
/Microcontroller/PA3_GPIO_U2RX_AIN3: IC205.13 (PA3); also elsewhere on the board
/Microcontroller/PA8_GPIO_MCO_FT: IC205.29 (PA8); also elsewhere on the board
/Microcontroller/PB0_GPIO_AIN8: IC205.18 (PB0); also elsewhere on the board
/Microcontroller/PB5_GPIO_FT: IC205.41 (PB5); also elsewhere on the board
/Microcontroller/PB12_SPI_~CS~_FT: IC205.25 (PB12), JP401.2 (B); also elsewhere on the board
/Microcontroller/PB13_SPI_CLK_FT: IC205.26 (PB13); also elsewhere on the board
/Microcontroller/PB14_SPI_MISO_FT: IC205.27 (PB14); also elsewhere on the board
/Microcontroller/PB15_SPI_MOSI_FT: IC205.28 (PB15); also elsewhere on the board
/Microcontroller/SWDCLK_TCK: IC205.37 (PA14), J402.4, TP404.1
/Microcontroller/SWDIO_TMS: IC205.34 (PA13), J402.2, TP401.1
/Microcontroller/TDI: IC205.38 (PA15), J402.8, TP405.1
/Microcontroller/TDO: IC205.39 (PB3), J402.6, TP406.1
/Microcontroller/~RESET~: IC205.7 (NRST), J402.10, TP403.1; also elsewhere on the board
/Microcontroller/~TRST~: IC205.40 (PB4), JP405.1 (A), TP402.1
/SCL: IC205.42 (PB6), R407.2; also elsewhere on the board
/SDA: IC205.43 (PB7), R406.2; also elsewhere on the board
/Stromversorgung/Vcc3V3SNS_1.20Vref: IC205.15 (PA5); also elsewhere on the board
/Stromversorgung/Vcc5VSNS_1.20Vref: IC205.16 (PA6); also elsewhere on the board
/Stromversorgung/Vcc24VSNS_1.25Vref: IC205.14 (PA4); also elsewhere on the board
GNDD: C401.2, C402.2, C403.2, D401.1 (K), D402.1 (K), J401.1 (GND), J402.3, JP402.2 (B), JP404.1 (A), JP405.3 (B), R411.2; also elsewhere on the board
unnamed: C402.1, IC205.6 (OSC_OUT/PD1), XTAL401.1
unnamed: C403.1, IC205.5 (OSC_IN/PD0), XTAL401.2
unnamed: D401.2 (A), R409.2
unnamed: D402.2 (A), R410.2
unnamed: IC205.2 (PC13), R410.1
unnamed: IC205.3 (PC14), R409.1
unnamed: IC205.4 (PC15), JP402.1 (A)
unnamed: IC205.30 (PA9), J401.4 (TX), R404.2
unnamed: IC205.31 (PA10), J401.5 (RX), R403.2
unnamed: IC205.32 (PA11), J401.3 (CTS), R402.2
unnamed: IC205.33 (PA12), J401.6 (RTS), R401.2
unnamed: IC205.44 (BOOT0), R411.1
unnamed: J402.1, JP403.2 (B)
unnamed: J402.5, JP404.2 (C)
unnamed: J402.9, JP405.2 (C)
unnamed: JP401.1 (A), R405.2

Notes on the sheet:
USART1_TX
USART1_RX
USART1_CTS (Console)
USART1_RTS (Console)
SWDIO / JTMS
SWDCLK / JTCK
JTDI
SPI2_NSS
SPI2_CLK
SPI2_MISO
SPI2_MOSI
I2C1_SCL
I2C1_SDA
USART3_TX (HEC-Bitstream)
USART3_RX (HEC-Bitstream)
SPI1_MOSI (Neopixel-Output per DMA)
JTAG-Interface
Pin 5 should be grounded, but some debuggers supply 5V here or 3V3 (i.e. STLINK/V2). Pin 7 is a Key-Pin for SWDIO, normally remove (pull out), RTCK for JTAG is not available, Pin 9 can be grounded for SWDIO, but connected to ~TRST~ for JTAG.
JTRST
JTDO
Console und Bootstrap
TODO: o STM32F0xx als Alternativ-Bestückung prüfen/vorsehen, entsprechend Pins beschalten o STM32F30x als Alternativ-Bestückung prüfen/vorsehen, entsprechend Pins beschalten o STM32F7xx als Alternativ-Bestückung prüfen/vorsehen, entsprechend Pins beschalten

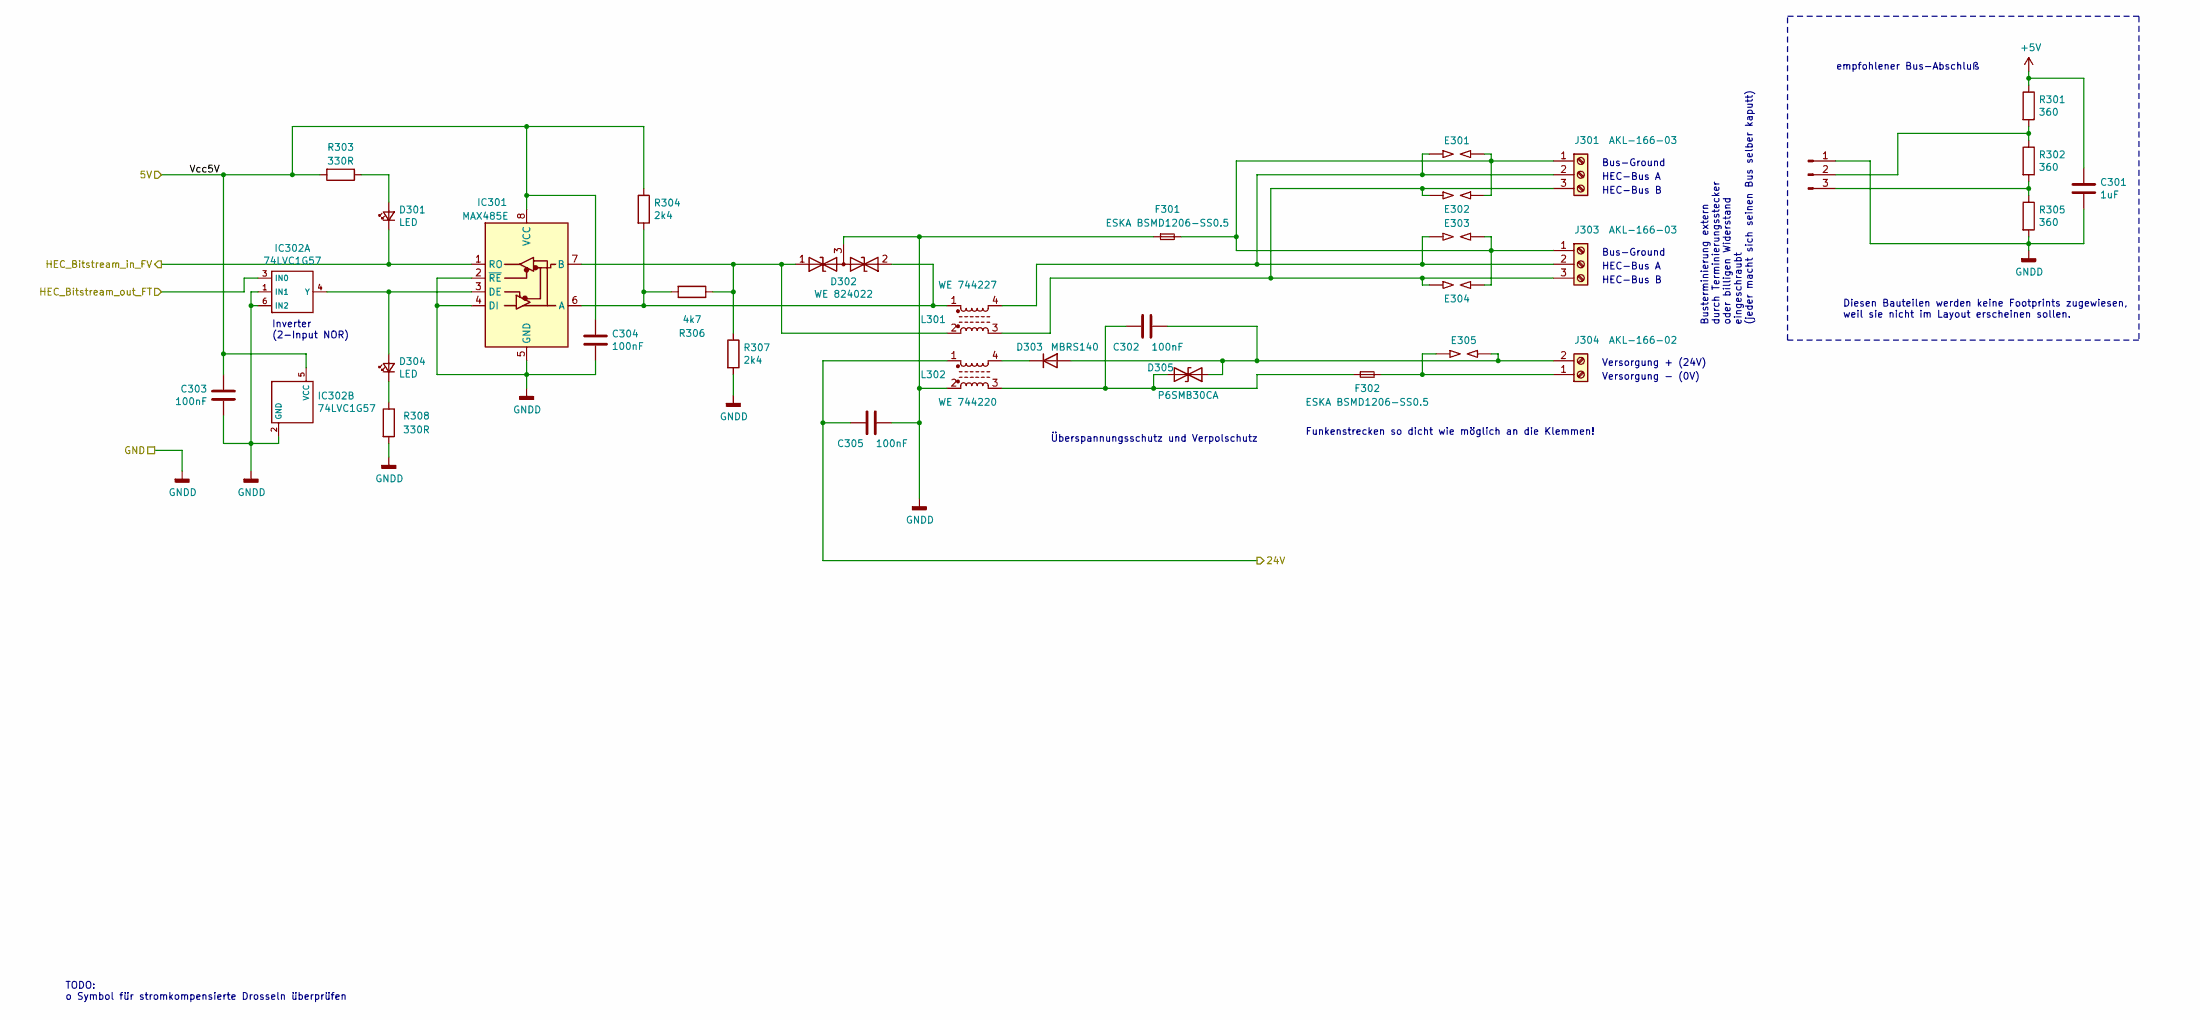
[picture p16: schematic HEC-Bus-Port.sch, Marienkaefer HEC-Basis-Bord: Bus-Anschaltung]

Parts:
C301: 1uF
C302, C303, C304, C305: 100nF; C_0603_1608Metric
D301, D304: LED; LED_0603_1608Metric
D302: WE 824022; SOT-23
D303: MBRS140; D_SMB
D305: P6SMB30CA; D_SMB
E301, E302, E303, E304, E305: SPARK_GAP; SparkGap_3pin_0.67x0.5mm
F301, F302: ESKA BSMD1206-SS0.5; R_1206_3216Metric
IC301: MAX485E; SO-8_3.9x4.9mm_P1.27mm
IC302: 74LVC1G57; SOT-363_SC-70-6
J301, J303: AKL-166-03; TerminalBlock_MetzConnect_Type059_RT06303HBWC_1x03_P3.50mm_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
J302: Conn_01x03_Male
J304: AKL-166-02; TerminalBlock_MetzConnect_Type059_RT06302HBWC_1x02_P3.50mm_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
L301: WE 744227; L_CommonMode_Wuerth_WE-SL2
L302: WE 744220; L_CommonMode_Wuerth_WE-SL2
R301, R302, R305: 360
R303, R308: 330R; R_0603_1608Metric
R304, R307: 2k4; R_0603_1608Metric
R306: 4k7; R_0603_1608Metric

Connections:
+5V: C303.1, C304.1, IC301.8 (VCC), IC302.5 (VCC), R303.2, R304.1; also elsewhere on the board
+24V: C305.2, L302.1; also elsewhere on the board
/Microcontroller/HEC-Bitstream-in-FT: D301.1 (K), IC301.1 (RO); also elsewhere on the board
/Microcontroller/HEC-Bitstream-out-FT: IC302.3 (IN0); also elsewhere on the board
GNDD: C301.2, C303.2, C304.2, C305.1, D302.3 (common), F301.1, IC301.2 (~RE), IC301.4 (DI), IC301.5 (GND), IC302.1 (IN1), IC302.2 (GND), IC302.6 (IN2), J302.1, L302.2, R305.2, R307.2, R308.2; also elsewhere on the board
unnamed: C301.1, R301.1
unnamed: C302.1, D303.2 (A), D305.1 (A1), E305.2, J304.2
unnamed: C302.2, D305.2 (A2), F302.1, L302.3
unnamed: D301.2 (A), R303.1
unnamed: D302.1 (A1), IC301.7 (B), L301.2, R306.1, R307.1
unnamed: D302.2 (A2), IC301.6 (A), L301.1, R304.2, R306.2
unnamed: D303.1 (K), L302.4
unnamed: D304.1 (K), R308.1
unnamed: D304.2 (A), IC301.3 (DE), IC302.4 (Y)
unnamed: E301.1, E303.1, J301.2, J303.2, L301.4
unnamed: E301.2, E302.2, E303.2, E304.2, F301.2, J301.1, J303.1
unnamed: E302.1, E304.1, J301.3, J303.3, L301.3
unnamed: E305.1, F302.2, J304.1
unnamed: J302.2, R301.2, R302.1
unnamed: J302.3, R302.2, R305.1

Notes on the sheet:
Bus-Ground
Versorgung + (24V)
Versorgung - (0V)
HEC-Bus B
HEC-Bus A
Busterminierung extern durch Terminierungsstecker oder billigen Widerstand eingeschraubt (jeder macht sich seinen Bus selber kaputt)
Funkenstrecken so dicht wie möglich an die Klemmen!
TODO: o Symbol für stromkompensierte Drosseln überprüfen
Überspannungsschutz und Verpolschutz
empfohlener Bus-Abschluß
Diesen Bauteilen werden keine Footprints zugewiesen, weil sie nicht im Layout erscheinen sollen.
Inverter (2-Input NOR)
