donnerruebe/HEC-LadyBug/cad/hec-base/hec-base.kicad_pcb

## KiCad design cad/hec-base/hec-base.kicad_pcb (continued)

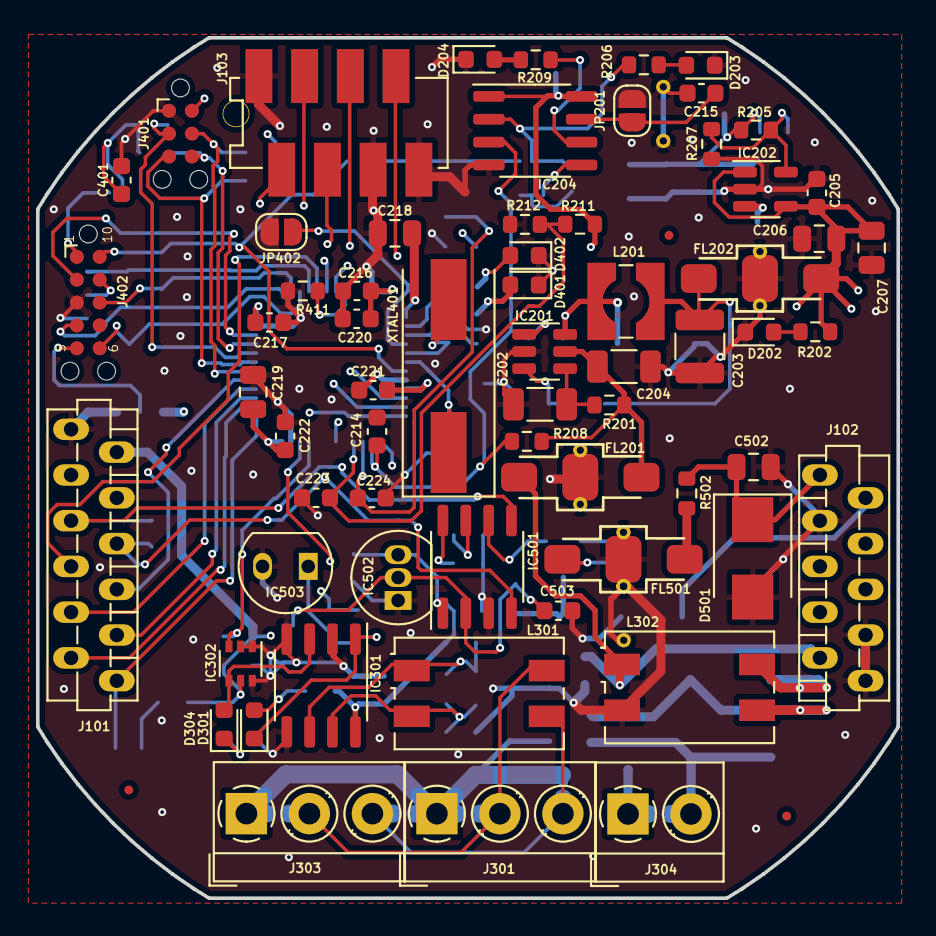
[picture p17: board hec-base.kicad_pcb from above]

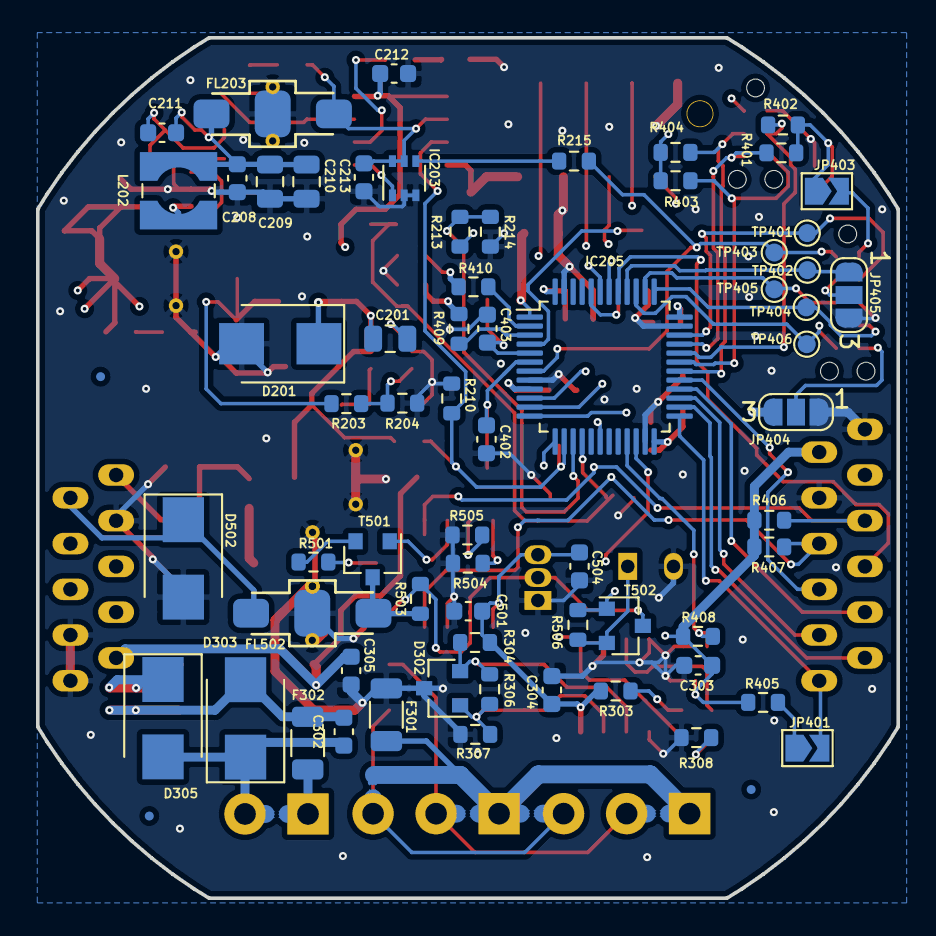
[picture p18: board hec-base.kicad_pcb from below]

Board: 4 copper layers, 47.8 x 47.8 mm, 140 parts (73 on the bottom side), 82 nets.
