donnerruebe/HEC-LadyBug/(commit log)

2022-08-14 Initial project directory layout, first schematic steps.
    [HEC-Bus-Port.sch, hec-base.kicad_pcb, hec-base.sch]
2022-08-14 Power-Management schematics input and dimensioning done.
    [HEC-Bus-Port.sch, hec-base.sch, power.sch]
2022-08-14 MCU-, Crypto- und One-Wire-Teil erstellt und dimensioniert, ERC bestanden, SLP geplottet, Footprints nur teilweise zugewiesen.
    [HEC-Bus-Port.sch, hec-base.sch, power.sch]
2022-08-14 MCU-, Crypto- und One-Wire-Teil dimensioniert, ERC bestanden, SLP geplottet.
    [mcu.sch, one-wire.sch]
2022-08-14 MT-Marienkaefer: Footprints fertig zugewiesen.
    [HEC-Bus-Port.sch, hec-base.sch, mcu.sch, one-wire.sch, power.sch]
2022-08-14 Entflochtene Leiterplatte mit Schaltplan speichern.
    [HEC-Bus-Port.sch, PCB-Outline.dxf, hec-base.kicad_pcb, hec-base.sch, mcu.sch, one-wire.sch, power.sch]
2022-08-14 MT-Marienkaefer: Schaltregler von Platinenkante verschoben.
    [hec-base.kicad_pcb]
2022-08-14 Alle in-akzeptablen DRC-Fehler im Layout behoben.
    [hec-base.kicad_pcb, power.sch]
2022-08-14 Texte für Silkscreen und Bestückungsplan platziert.
    [hec-base.kicad_pcb, power.sch]
2022-08-14 Gerberdaten erstellt.
    [hec-base-B_Cu.gbr, hec-base-B_Fab.gbr, hec-base-B_Mask.gbr, hec-base-B_Paste.gbr, hec-base-B_SilkS.gbr, hec-base-Edge_Cuts.gbr, hec-base-F_Cu.gbr, hec-base-F_Fab.gbr]
2022-08-14 BOM's erstellt.
    [hec-base_BOM-by-value.csv, hec-base_BOM-list.csv]
